3dPaulHarvey/Hexapod/_CODE/_REF/hexapod-main/hexapod-main/README.md

#  Hexapod

A 3D Printed Hexapod Robot

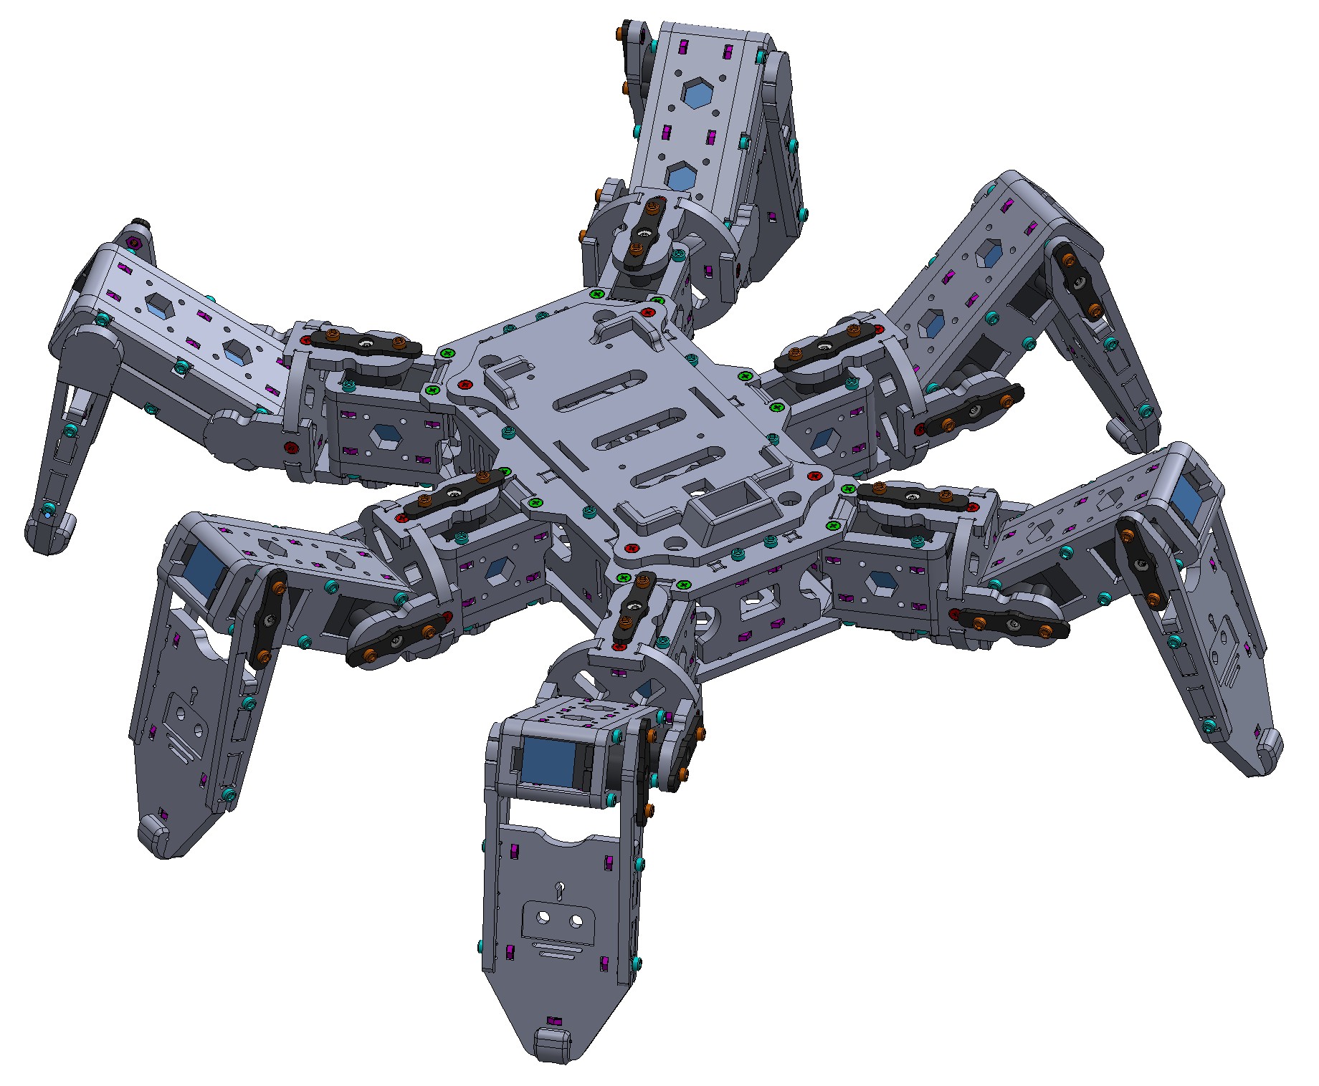
[picture p1: _CODE/_REF/hexapod-main/hexapod-main/images/hexapod_model.jpg]
hexapod_model


booting_up

## Introduction

This agile, 3D-printed hexapod robot, built with ESP32 and Arduino, offers a range of advanced features, including:

- A robust, durable structure
- WiFi-enabled remote control
- Smooth, agile movement
- Over-the-air (OTA) firmware updates for easy maintenance

### Watch on Youtube

youtube_booting_up (https://www.youtube.com/watch?v=QFQOPC1Mbdo)

youtube_remote_control (https://www.youtube.com/watch?v=YvXEto3tymQ)

## Electronics

| Name | Thumbnail | Required | Note |
| --- | --- | --- | --- |
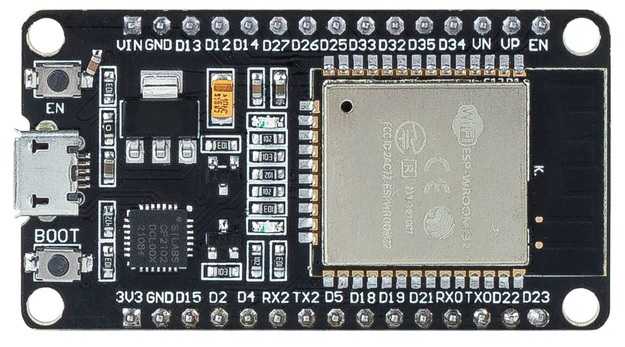
[picture p2: _CODE/_REF/hexapod-main/hexapod-main/images/esp32.jpg]
esp32
| ESP32 Dev Module |  | 1 | |
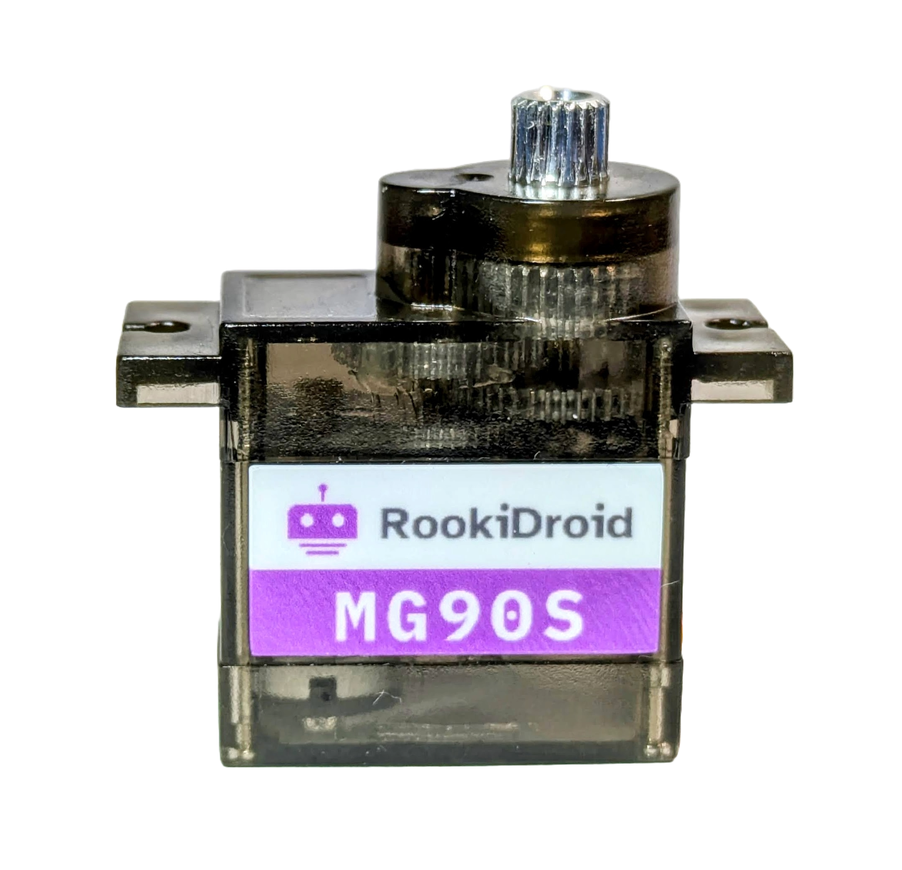
[picture p3: _CODE/_REF/hexapod-main/hexapod-main/images/mg90s.png]
mg90s
| MG92B or MG90S (metal gear)|  | 18 | Can be mixed |
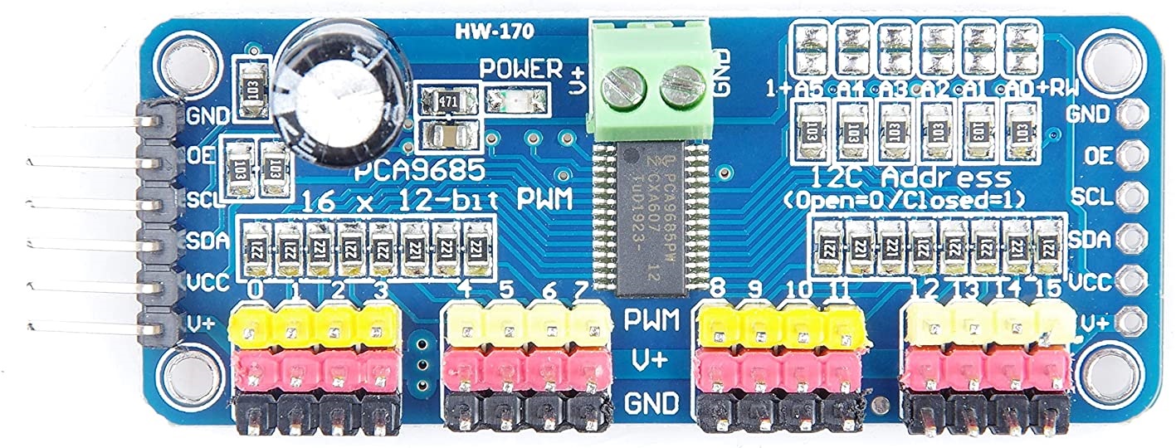
[picture p4: _CODE/_REF/hexapod-main/hexapod-main/images/PCA9685.jpg]
PCA9685
| PCA9685 servo driver |  | 2 | Need to be configured as different I2C addresss |
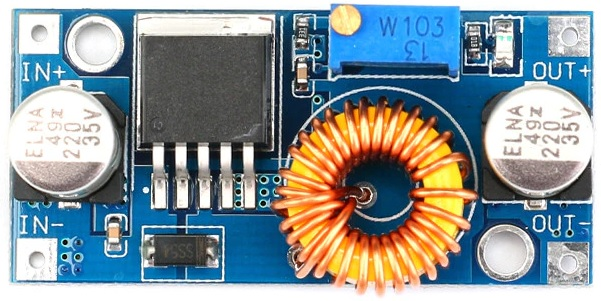
[picture p5: _CODE/_REF/hexapod-main/hexapod-main/images/XL4005.jpg]
XL4005
| XL4005 DC-DC step down |  | 2 | 6V output |
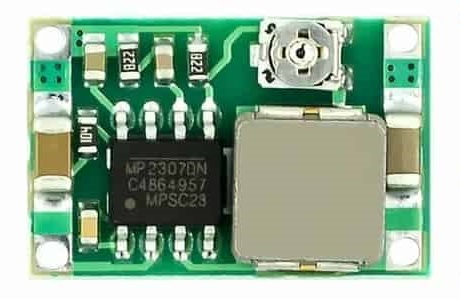
[picture p6: _CODE/_REF/hexapod-main/hexapod-main/images/mini360.jpg]
mini360
| Mini 360 DC-DC step down |  | 1 | 5V output |
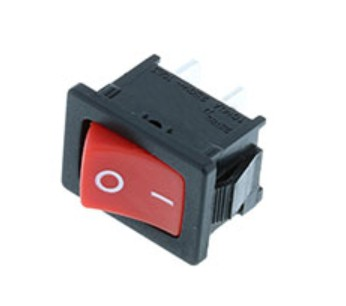
[picture p7: _CODE/_REF/hexapod-main/hexapod-main/images/switch.jpg]
switch
| Switch |  | 1 | |
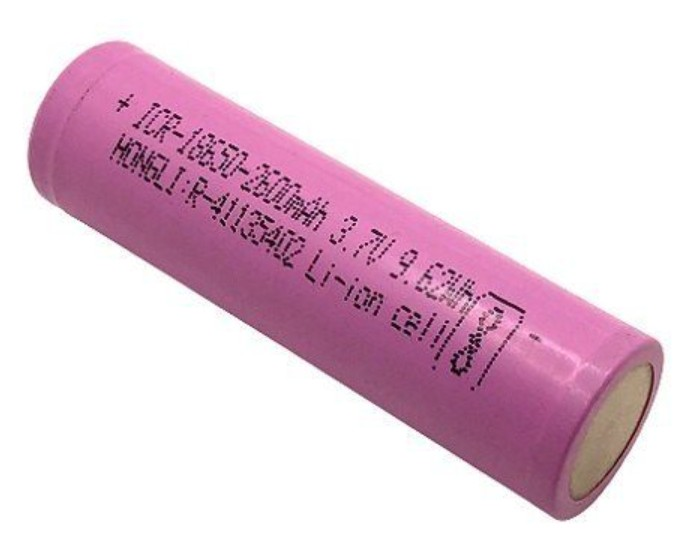
[picture p8: _CODE/_REF/hexapod-main/hexapod-main/images/battery.jpg]
battery
| 18650 battery |  | 2 | |
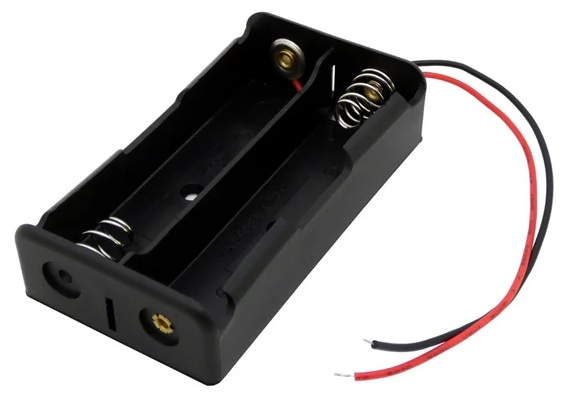
[picture p9: _CODE/_REF/hexapod-main/hexapod-main/images/battery_holder.jpg]
batter_holder
| 18650 battery holder |   | 1 | |

### Connection Diagram

diagram

## Assembly

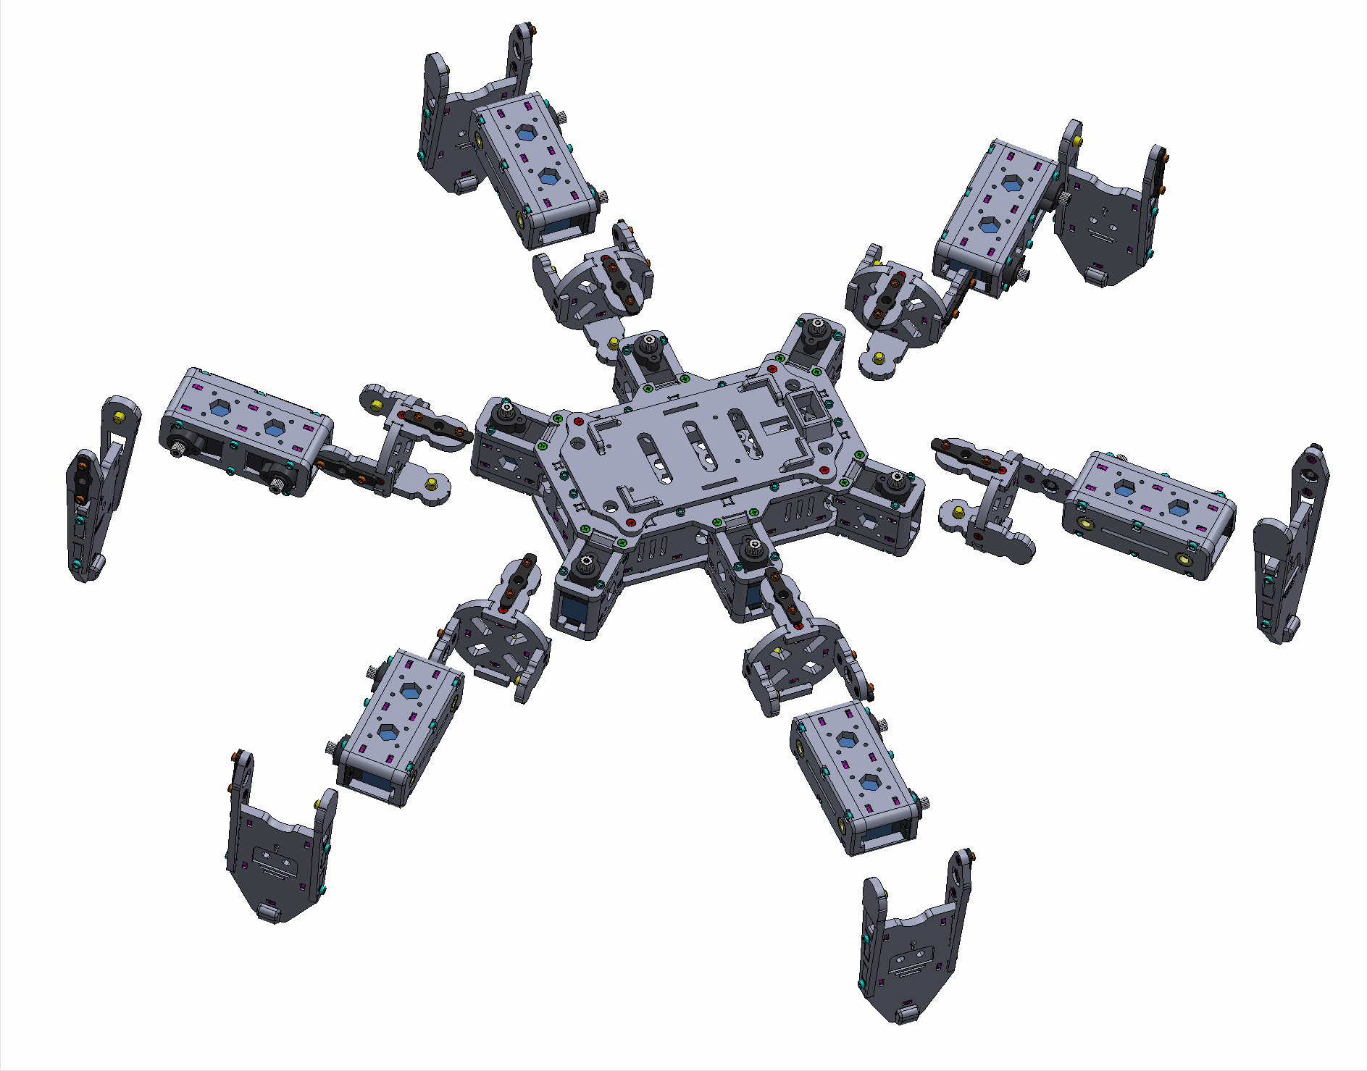
[picture p10: _CODE/_REF/hexapod-main/hexapod-main/images/assembly_whole.gif]
whole_assembly


### 3D-Printed Parts

#### Body x 1

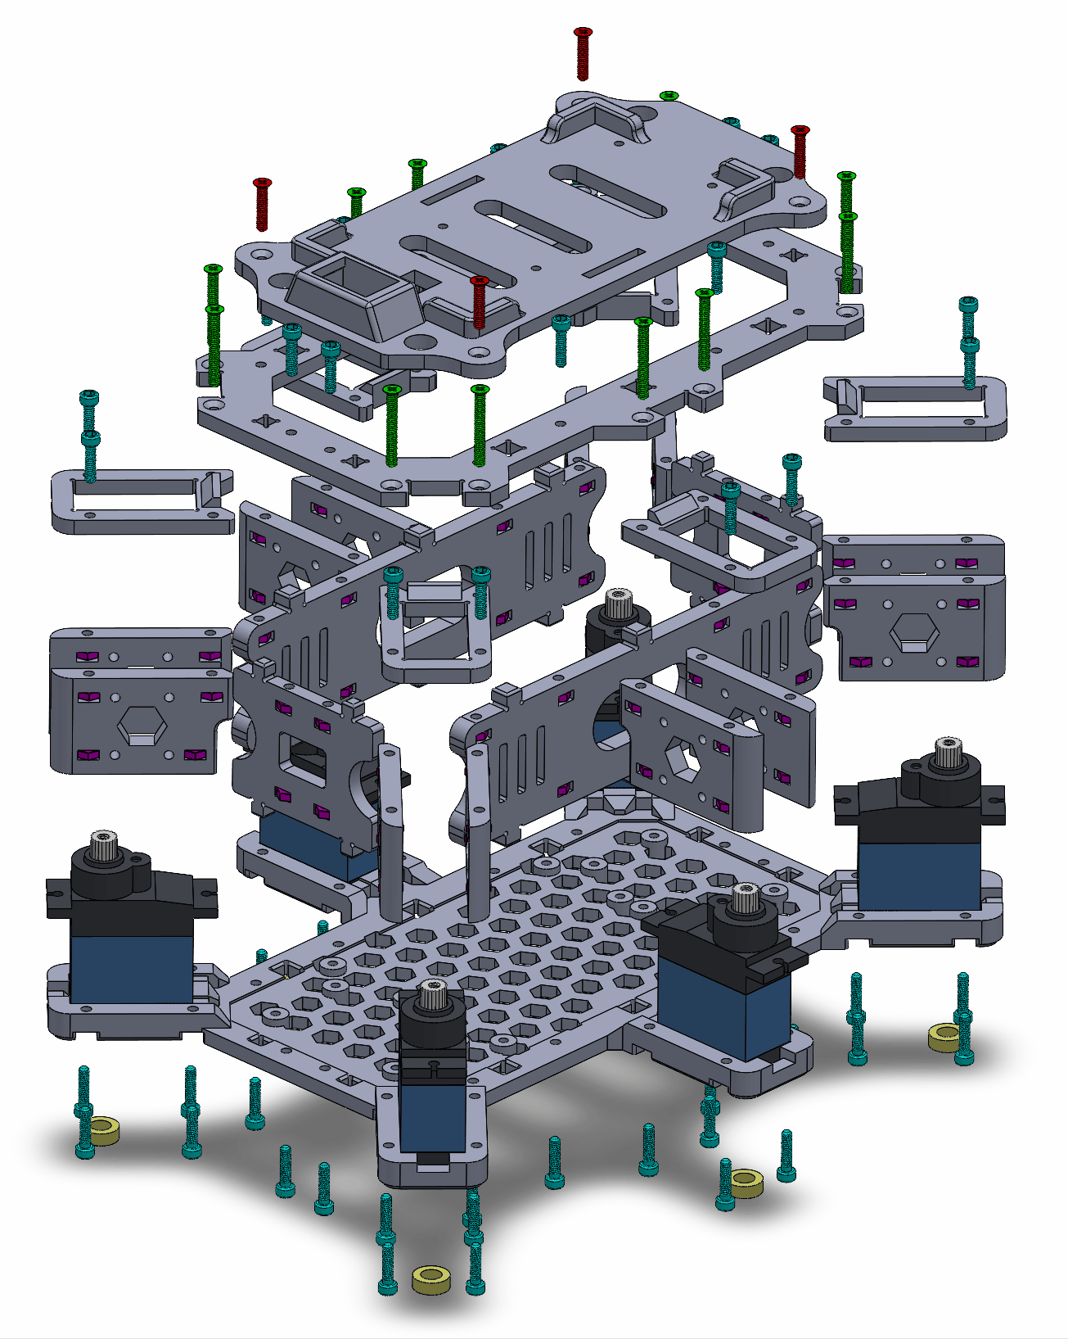
[picture p11: _CODE/_REF/hexapod-main/hexapod-main/images/assembly_body.gif]
body_assembly


| Filename | Thumbnail | Required |
| --- | --- | --- |
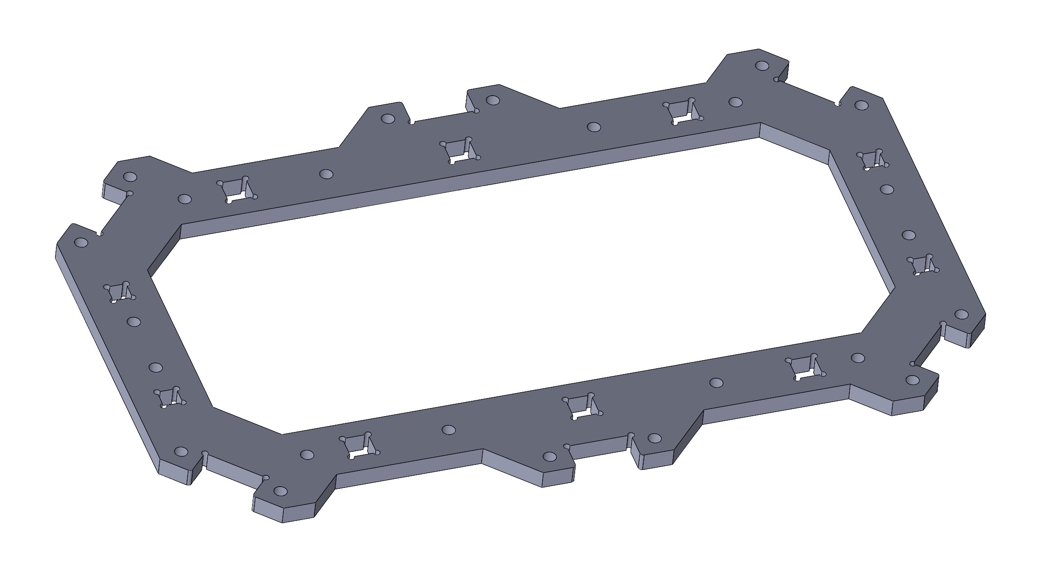
[picture p12: _CODE/_REF/hexapod-main/hexapod-main/images/body_top.jpg]
body_top
| body_top |  | 1 |
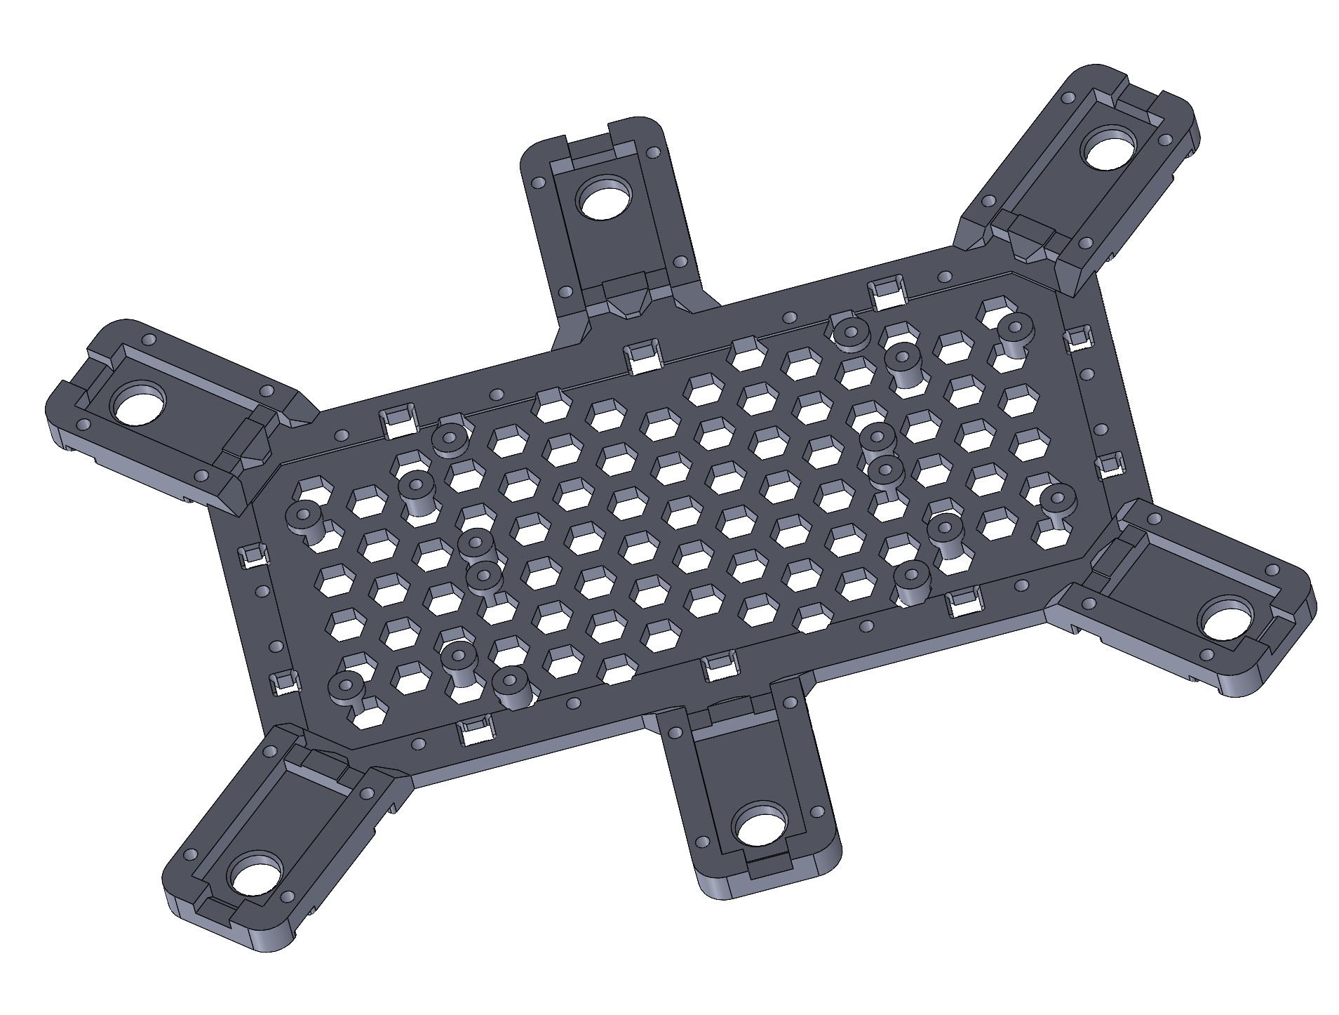
[picture p13: _CODE/_REF/hexapod-main/hexapod-main/images/body_base.jpg]
body_base
| body_base |  | 1 |
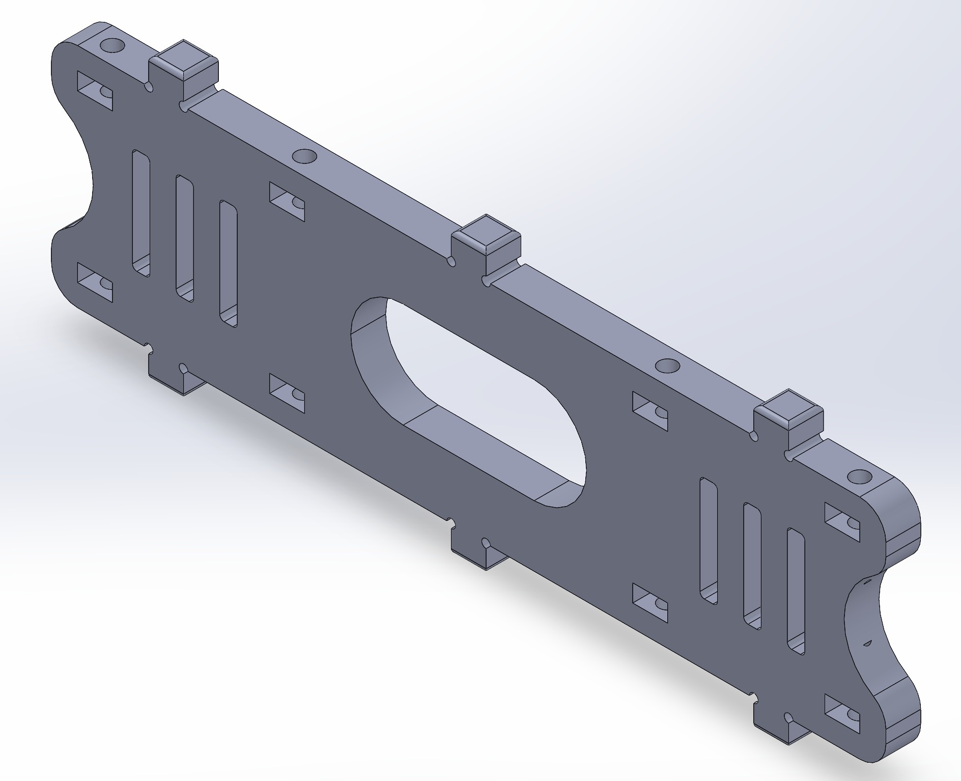
[picture p14: _CODE/_REF/hexapod-main/hexapod-main/images/body_side.jpg]
body_side
| body_side |  | 2 |
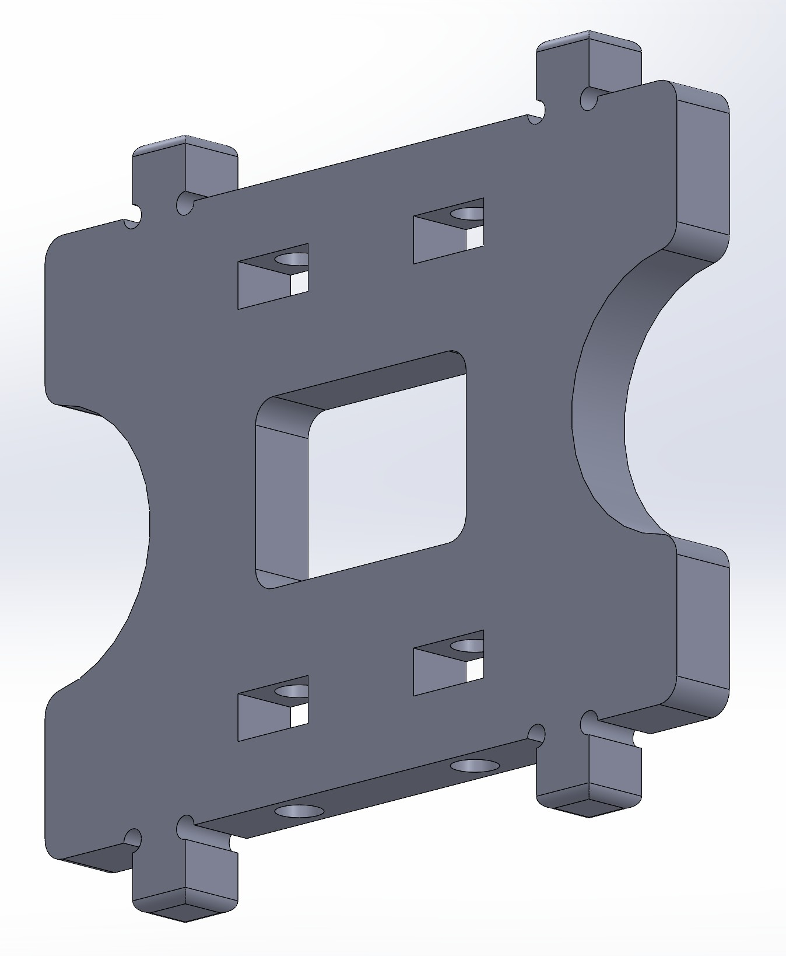
[picture p15: _CODE/_REF/hexapod-main/hexapod-main/images/body_front_back.jpg]
body_front_back
| body_front_back| | 2 |
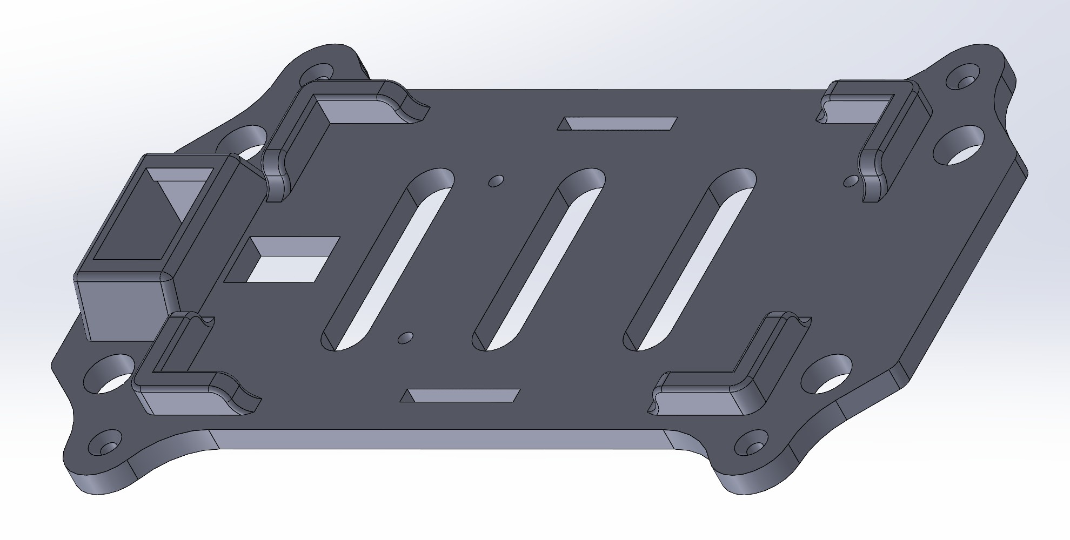
[picture p16: _CODE/_REF/hexapod-main/hexapod-main/images/body_battery.jpg]
body_battery
| body_battery |  | 1 |
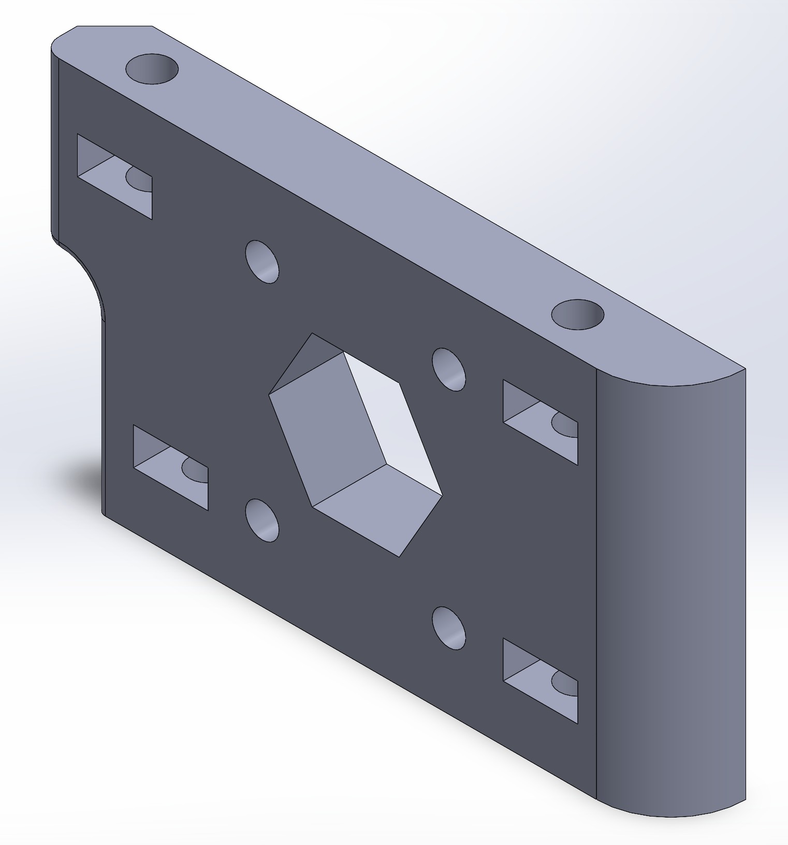
[picture p17: _CODE/_REF/hexapod-main/hexapod-main/images/body_servo_side1.jpg]
body_servo_side1
| body_servo_side1 |  | 6 |
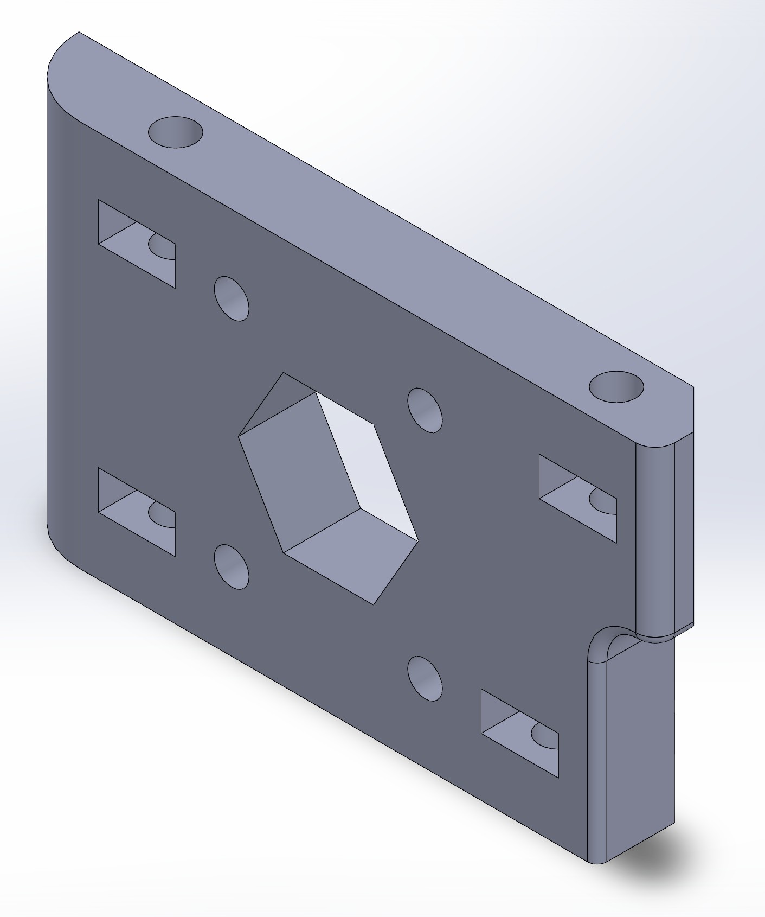
[picture p18: _CODE/_REF/hexapod-main/hexapod-main/images/body_servo_side2.jpg]
body_servo_side2
| body_servo_side2 |  | 6 |
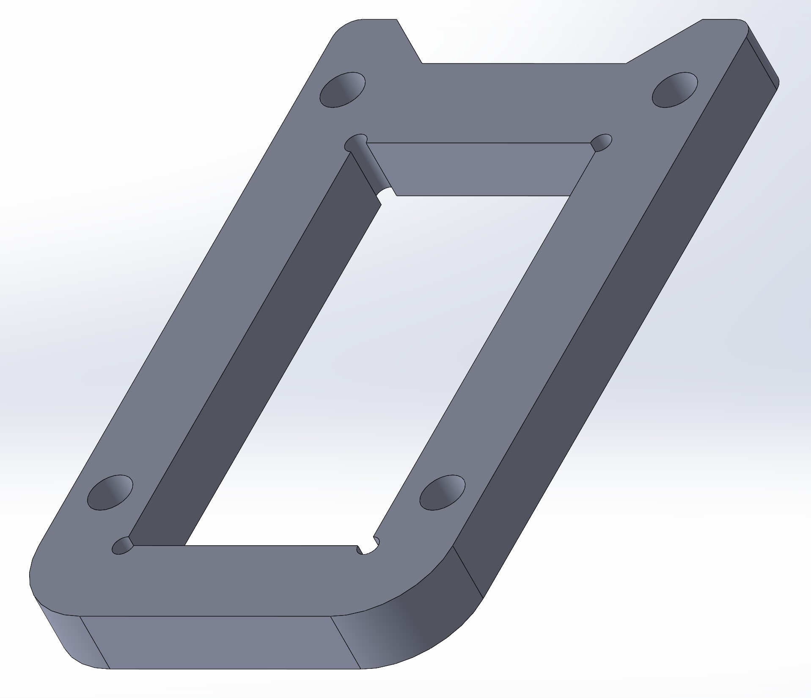
[picture p19: _CODE/_REF/hexapod-main/hexapod-main/images/body_servo_top.jpg]
body_servo_top
| body_servo_top |  | 6 |

#### Joint x 3 + Mirrored Joint x 3

*Check the images of the fully assembled robot for the orientations of the joints and the mirrored joints*

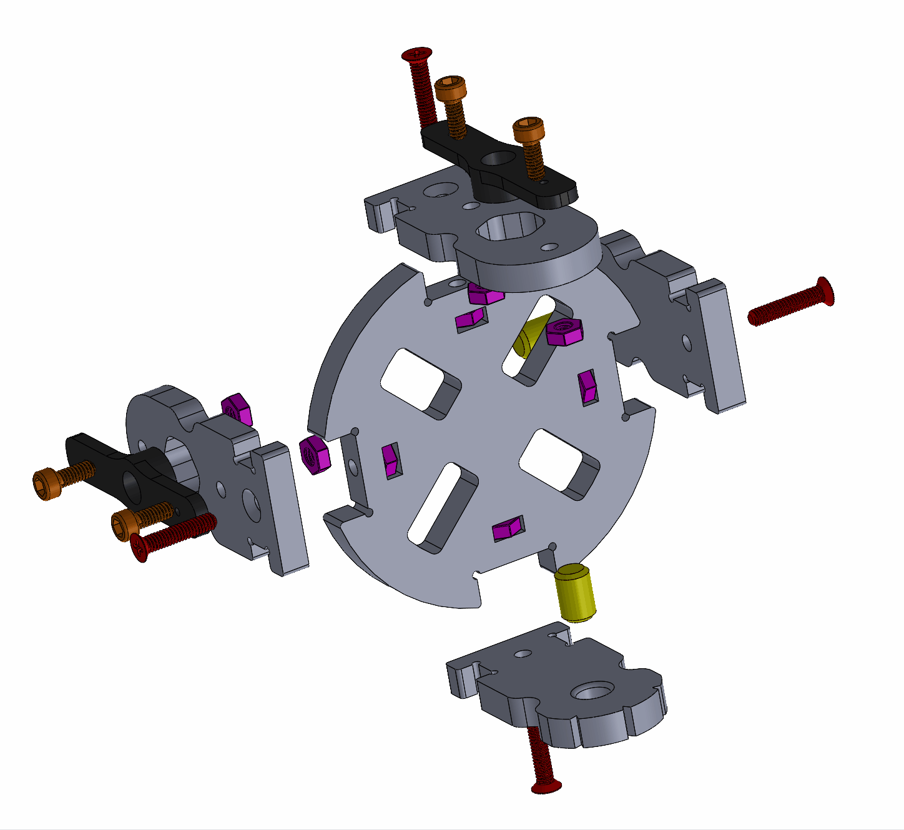
[picture p20: _CODE/_REF/hexapod-main/hexapod-main/images/assembly_joint.gif]
joint_assembly


| Filename | Thumbnail | Required | Note |
| --- | --- | --- | --- |
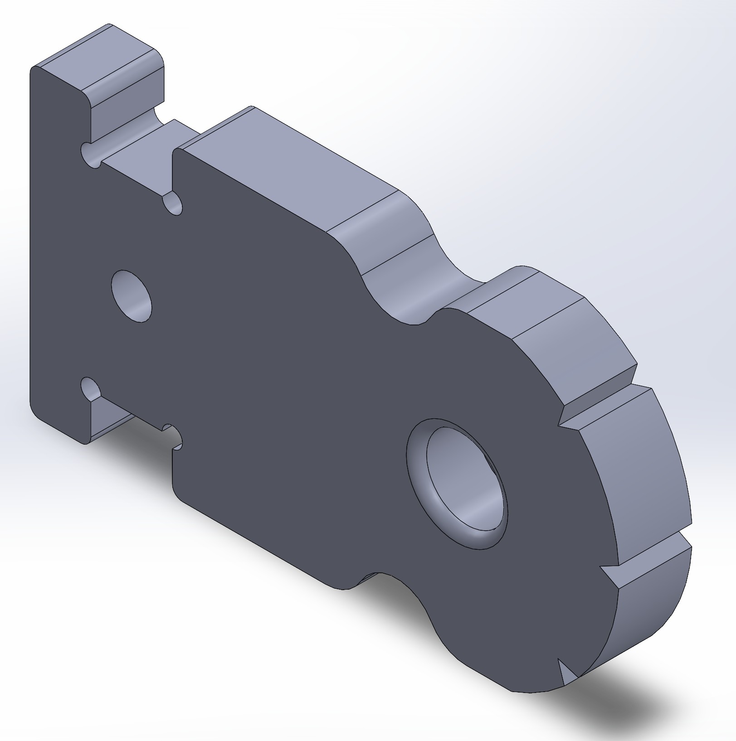
[picture p21: _CODE/_REF/hexapod-main/hexapod-main/images/joint_bottom.jpg]
joint_bottom
| joint_bottom |  | 12 | |
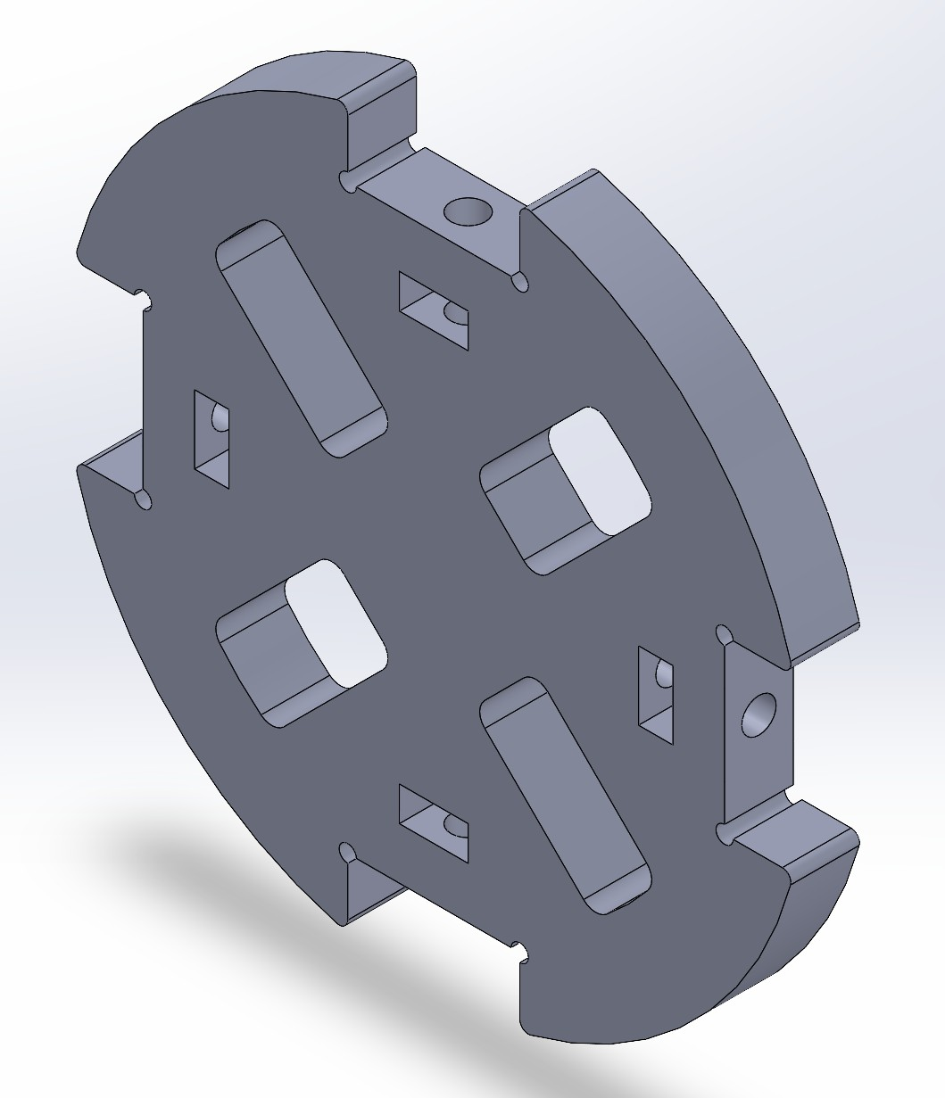
[picture p22: _CODE/_REF/hexapod-main/hexapod-main/images/joint_cross.jpg]
joint_cross
| joint_cross |  | 6 | |
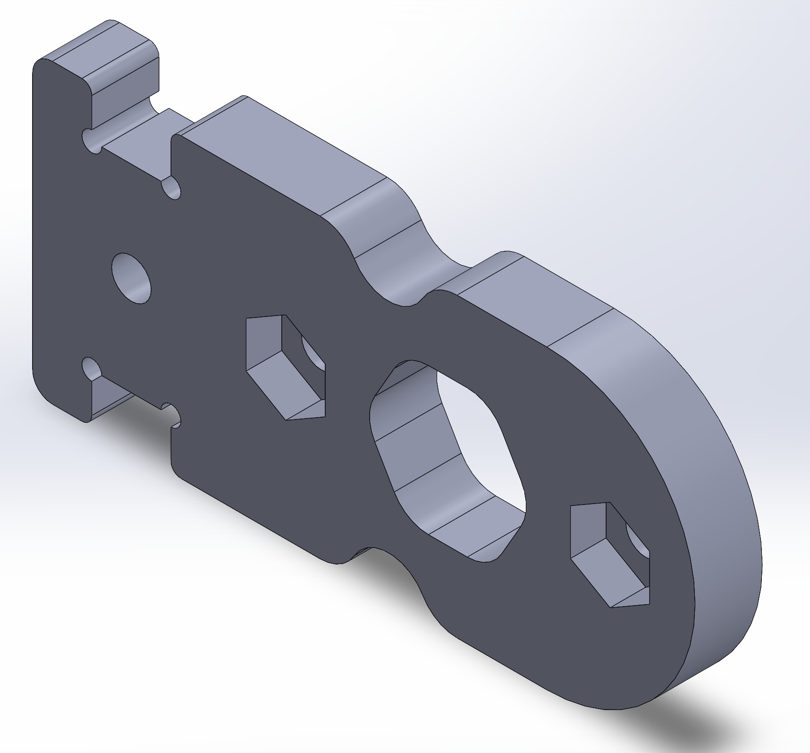
[picture p23: _CODE/_REF/hexapod-main/hexapod-main/images/joint_top_mg90s.jpg]
joint_top_mg90s
| joint_top_mg90s |  | 12 | For MG90S |
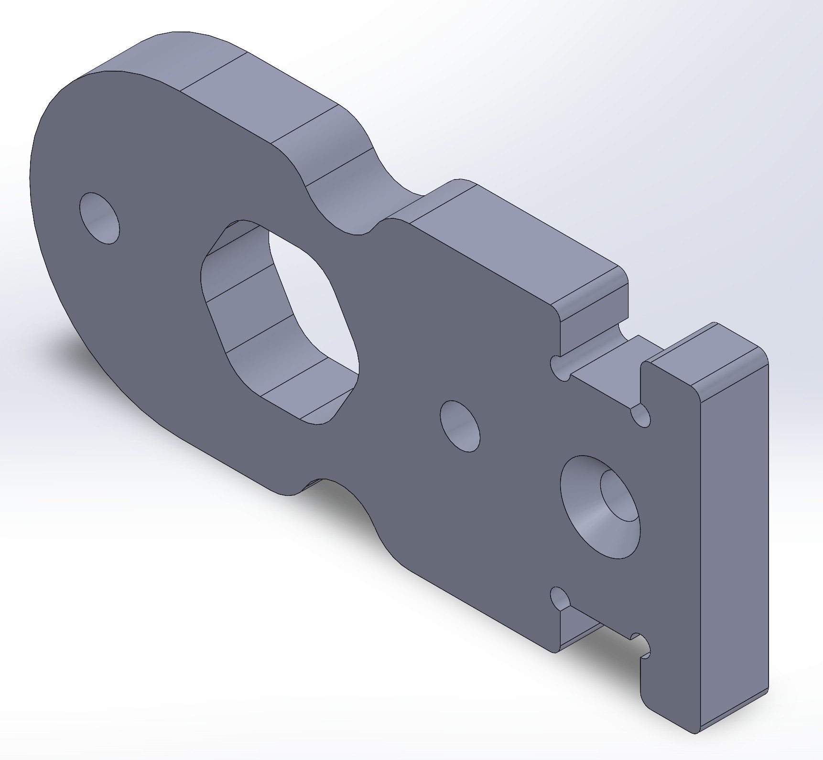
[picture p24: _CODE/_REF/hexapod-main/hexapod-main/images/joint_top_mg92b.jpg]
joint_top_mg92b
| joint_top_mg92b |  | 12 | For MG92B |

#### Leg x 6

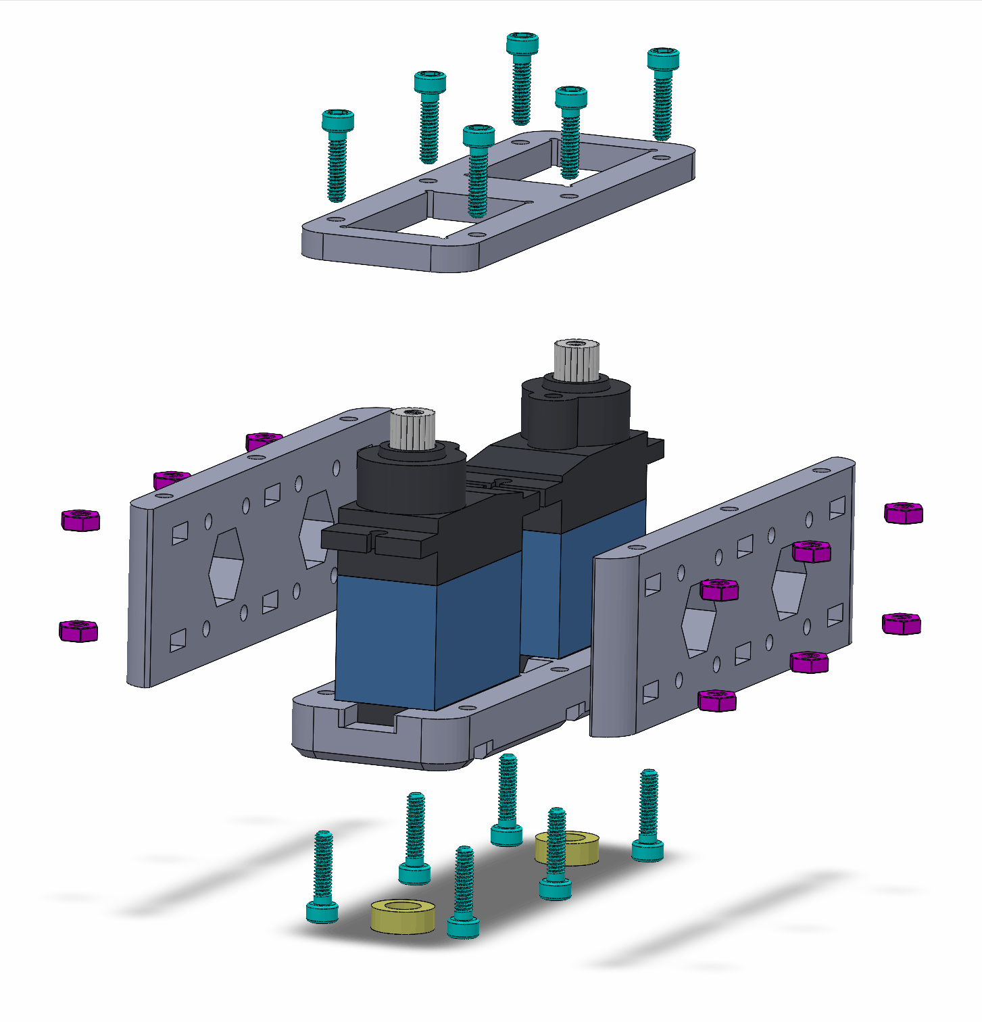
[picture p25: _CODE/_REF/hexapod-main/hexapod-main/images/assembly_leg.gif]
leg_assembly


| Filename | Thumbnail | Required |
| --- | --- | --- |
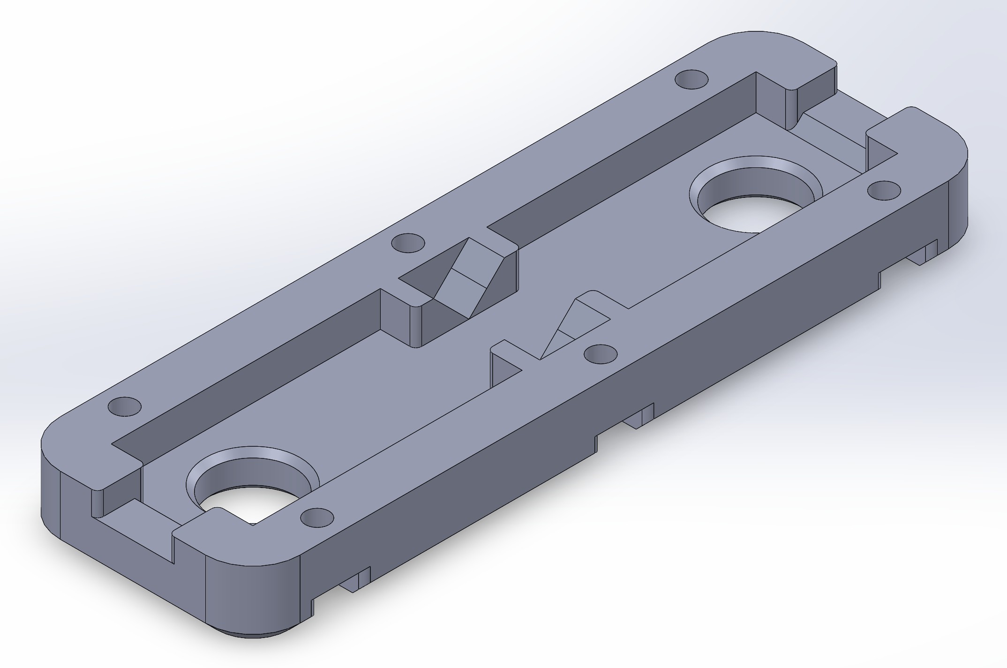
[picture p26: _CODE/_REF/hexapod-main/hexapod-main/images/leg_bottom.jpg]
leg_bottom
| leg_bottom |  | 6 |
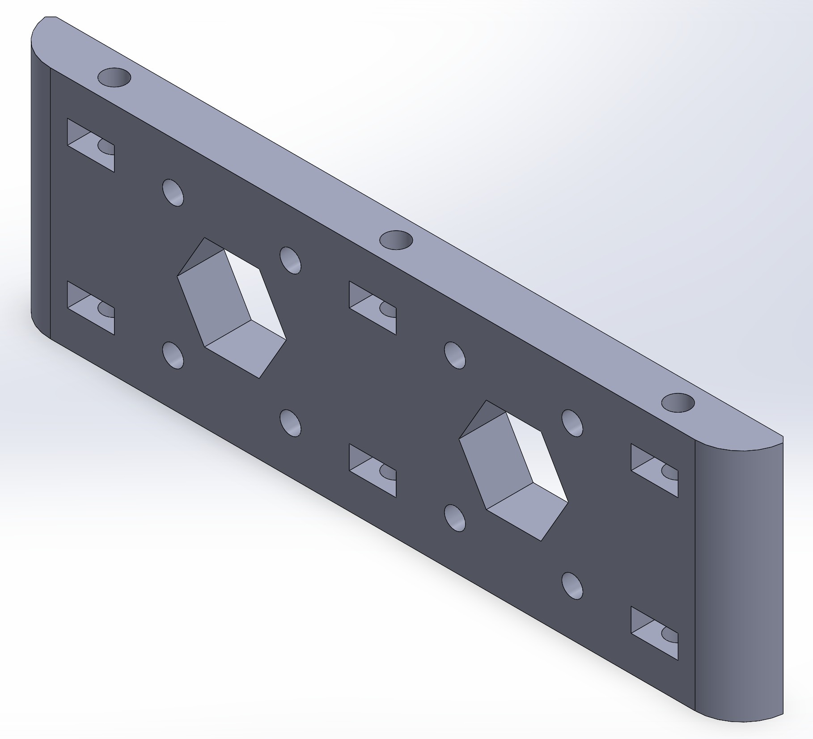
[picture p27: _CODE/_REF/hexapod-main/hexapod-main/images/leg_side.jpg]
leg_side
| leg_side |  | 12 |
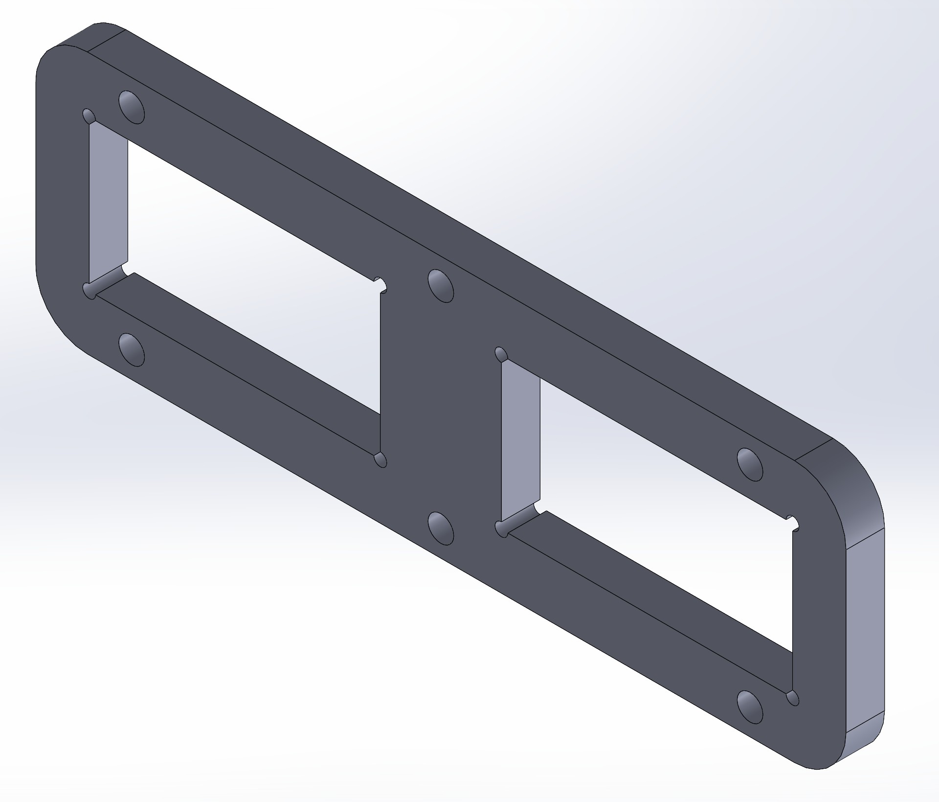
[picture p28: _CODE/_REF/hexapod-main/hexapod-main/images/leg_top.jpg]
leg_top
| leg_top |  | 6 |

#### Foot x 3 + Mirrored Foot x 3

*Check the images of the fully assembled robot for the orientations of the feet and the mirrored feet*

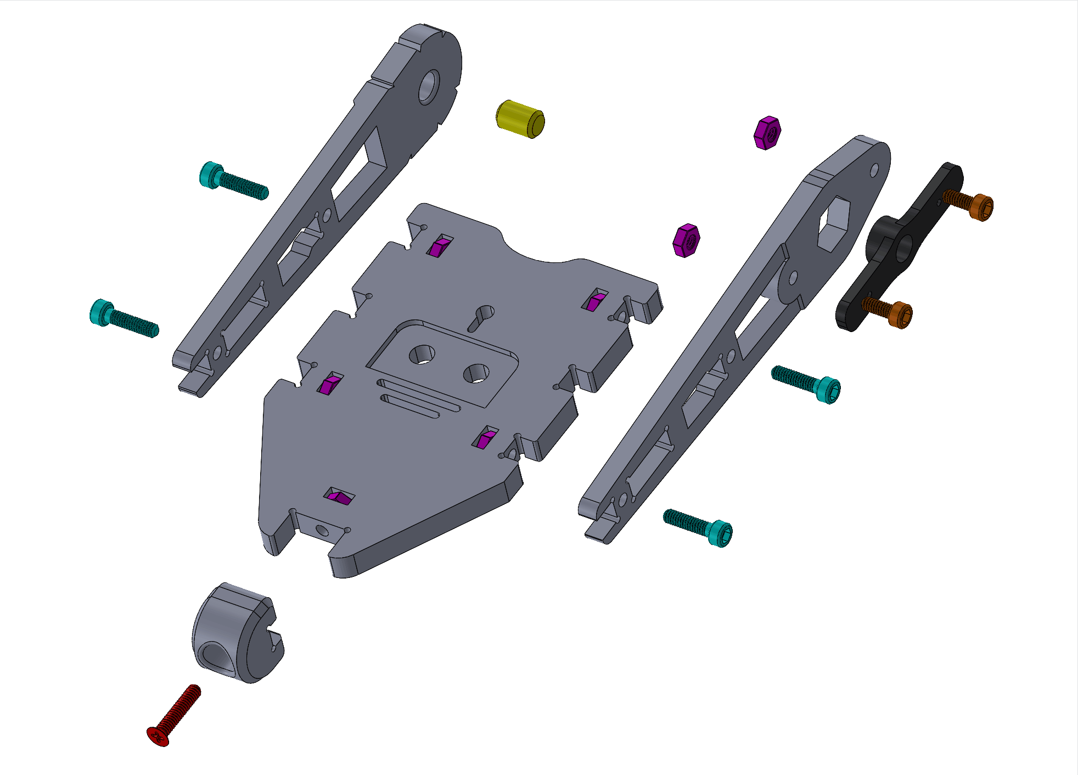
[picture p29: _CODE/_REF/hexapod-main/hexapod-main/images/assembly_foot.gif]
foot_assembly


| Filename | Thumbnail | Required | Note |
| --- | --- | --- | --- |
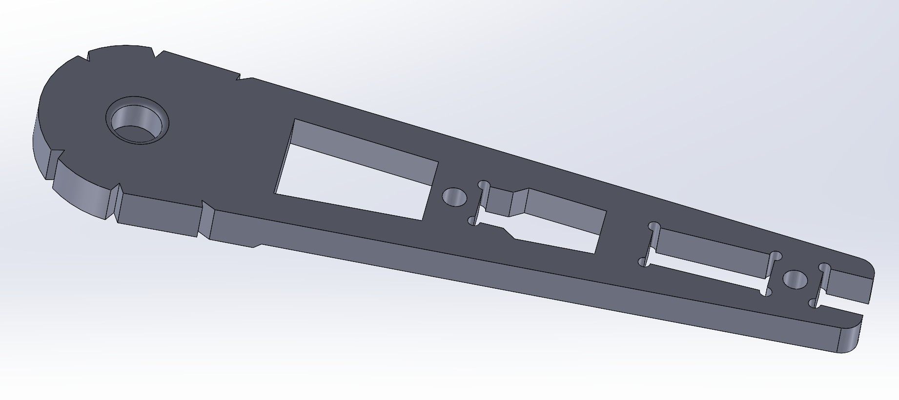
[picture p30: _CODE/_REF/hexapod-main/hexapod-main/images/foot_bottom.jpg]
foot_bottom
| foot_bottom |  | 6 | |
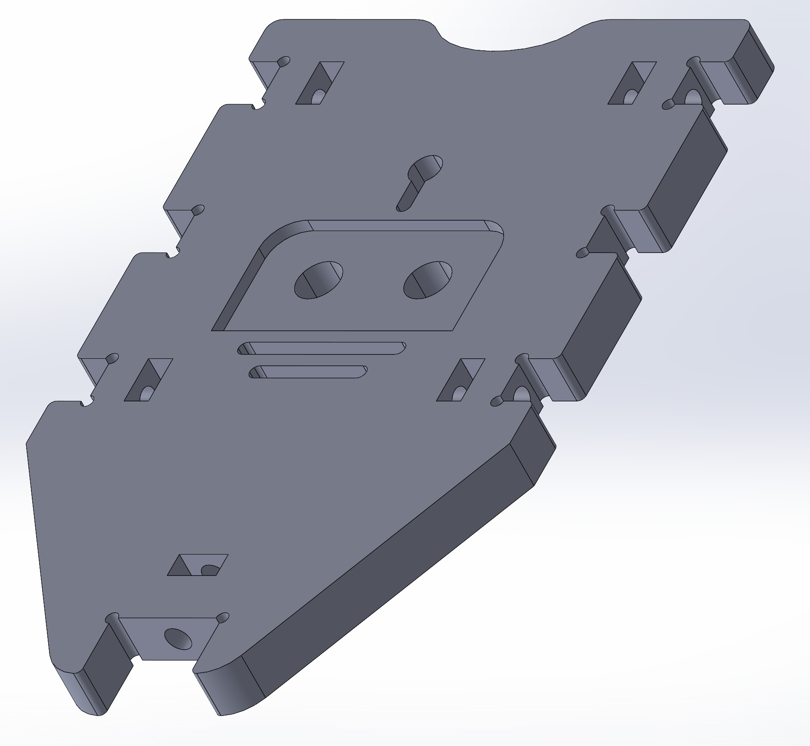
[picture p31: _CODE/_REF/hexapod-main/hexapod-main/images/foot_ground.jpg]
foot_ground
| foot_ground |  | 6 | |
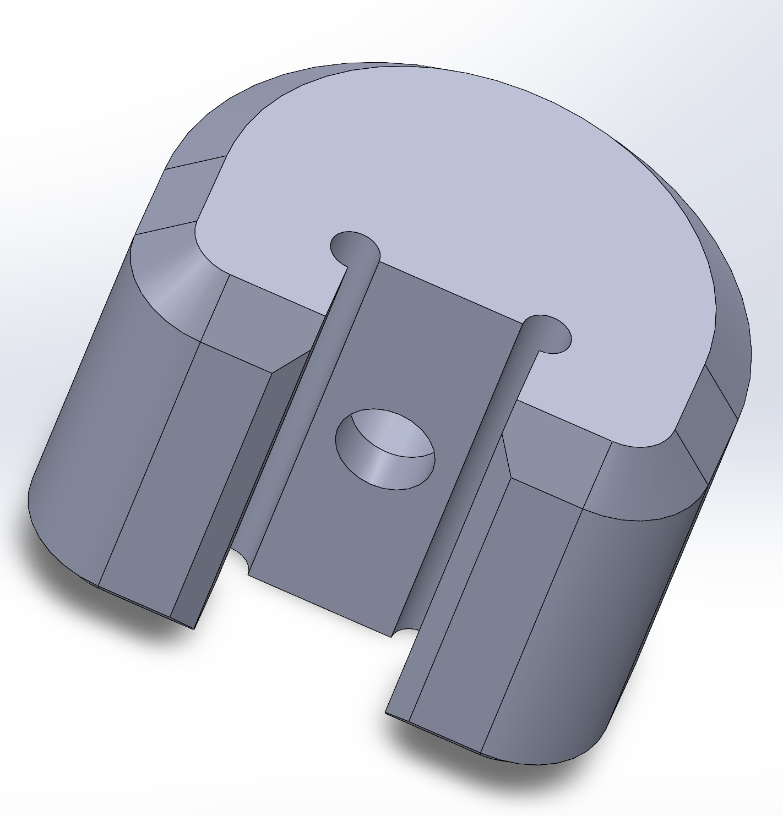
[picture p32: _CODE/_REF/hexapod-main/hexapod-main/images/foot_tip.jpg]
foot_tip
| foot_tip |  | 6 | |
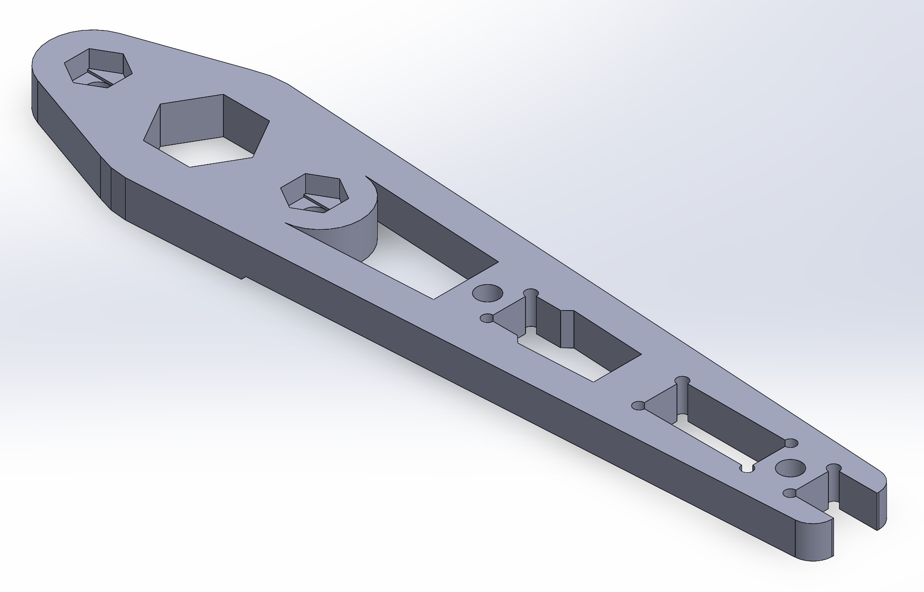
[picture p33: _CODE/_REF/hexapod-main/hexapod-main/images/foot_top_mg90s.jpg]
foot_top_mg90s
| foot_top_mg90s  |  | 6 | For MG90S |
| foot_top_mg92b  | foot_top_mg92b | 6 | For MG92B |

#### Accessory

| Filename | Thumbnail | Note |
| --- | --- | --- |
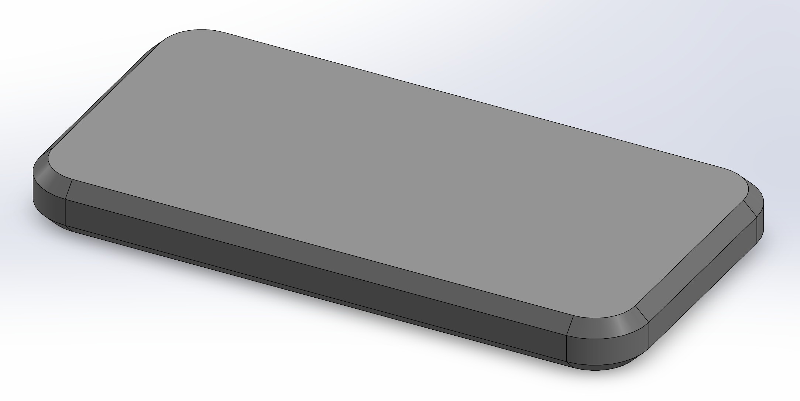
[picture p34: _CODE/_REF/hexapod-main/hexapod-main/images/accessory_spacer_mg90s.jpg]
accessory_spacer_mg90s
| accessory_spacer_mg90s |  | Spacer for MG90S |
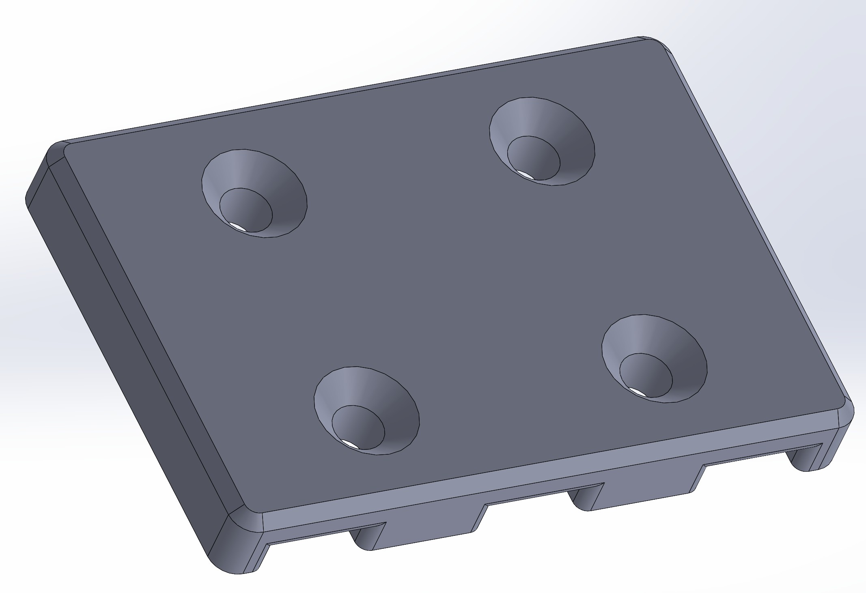
[picture p35: _CODE/_REF/hexapod-main/hexapod-main/images/accessory_cable_holder.jpg]
accessory_cable_holder
| accessory_cable_holder |  | |

### Others

| Name | Spec | Required |
| --- | --- | --- |
| Screw | M2 6mm  | 36 |
| Screw | M2 10mm | 198 |
| Nuts | M2 | 234 |
| Pin (304) | M4 6mm  | 18 |
| Bearing | MR74-2RS (4mm ID, 7mm OD, 2.5mm Bore) | 18 |

## Software

hexapod_model_label

### ESP32-Arduino

Source code is under `./hexapod_arduino`.

- `hexapod_arduino.ino`: Main Arduino sketch
- `config.h`: Configuration header. Change the configurations based on your servo connections
- `motion.h`: Automatically generated motion look-up-table using `path_tool'

### Android

*Working in progress*

### PC

*Working in progress*

## Calibration

Check the following image for the initial positions of all the leg joints while all the servos are at 90 deg.

Adjust the following two lines in in `config.h` to correct the installation offsets.

```c
static int left_offset_ticks[3][3] = {{-5, 10, 0}, {-15, 5, -20}, {20, -10, 10}};
static int right_offset_ticks[3][3] = {{20, -10, 0}, {-15, 0, -5}, {-10, 0, -20}};
```

calibration
