3dPaulHarvey/Hexapod/_NOTES.txt

put aster servos in the hips
servo horn screws facing outward, screw little horns on them

make him cyborg
MECH AZMODAN
using vitaly parts
