3dPaulHarvey/Hexapod/_ART/_REF/azmodan-color-hots/textures/storm_hero_azmodan_emis.png

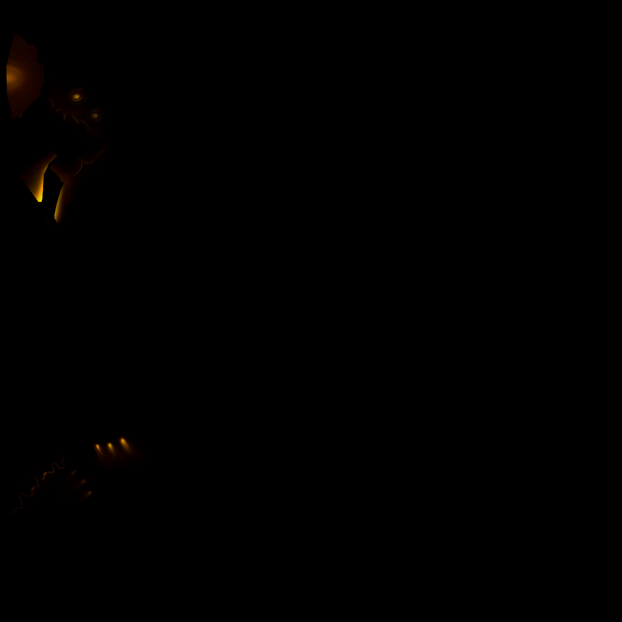
_ART/_REF/azmodan-color-hots/textures/storm_hero_azmodan_emis.png
