3dPaulHarvey/Hexapod/_CAD/ASSEM-SUB- SINGLE LEG.SLDASM

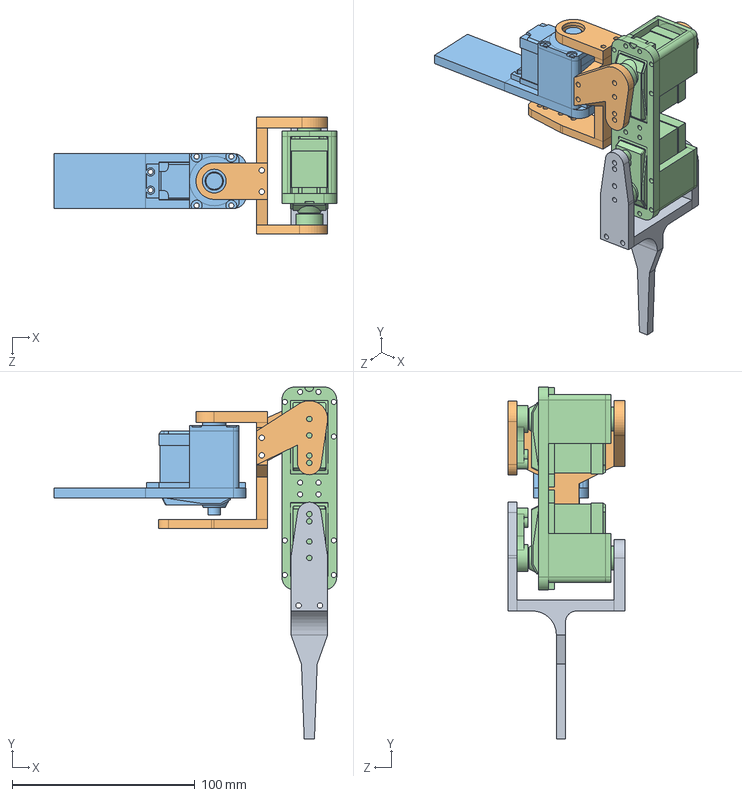
[picture p37: CAD file, 2026-02-27]
_CAD/ASSEM-SUB- SINGLE LEG.SLDASM
154.5 x 192.5 x 63.9 mm
KNEE LINK- AZHEX
HIP BASE- AZHEX
HIP KNEE CONNECTOR- AZHEX
END EFFECTOR- AZHEX
