3dPaulHarvey/Hexapod/_CODE/_REF/hexapod-main/hexapod-main/mechanism/body_servo_side2.STL

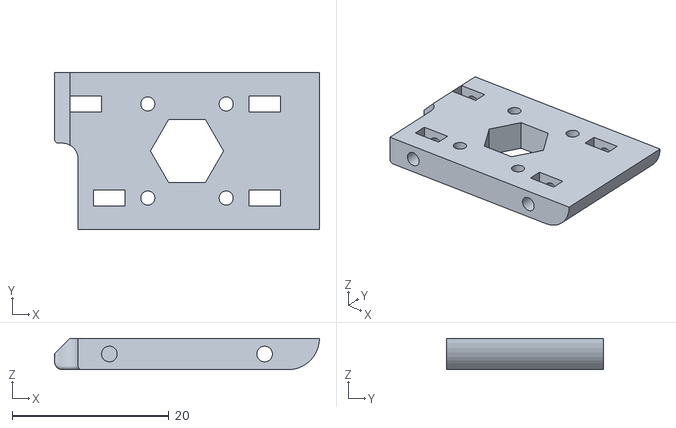
[picture p38: CAD file, 2026-02-14]
_CODE/_REF/hexapod-main/hexapod-main/mechanism/body_servo_side2.STL
33.8 x 20.0 x 4.00
