3dPaulHarvey/Hexapod/_CAD/KNEE LINK- AZHEX.SLDPRT

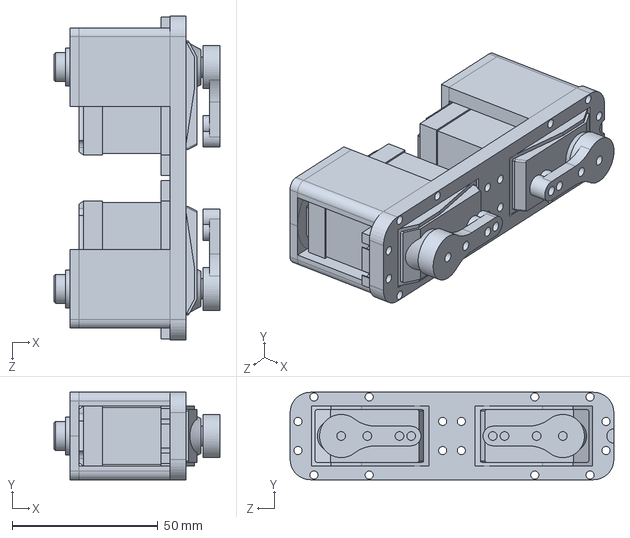
[picture p39: CAD file, 2026-02-27]
_CAD/KNEE LINK- AZHEX.SLDPRT
56.9 x 30.0 x 111.0 mm
