3dPaulHarvey/Hexapod/_CODE/_REF/hexapod-main/hexapod-main/mechanism/joint_top_mg90s.STL

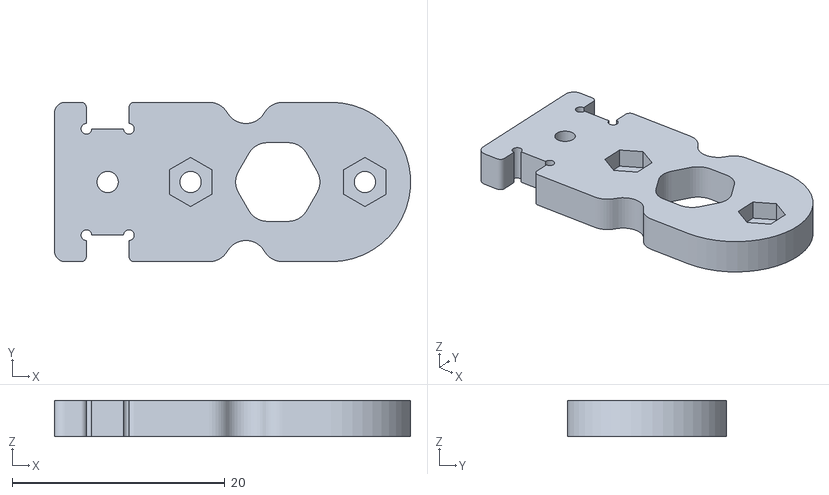
[picture p40: CAD file, 2026-02-14]
_CODE/_REF/hexapod-main/hexapod-main/mechanism/joint_top_mg90s.STL
33.5 x 15.0 x 3.40
