3dPaulHarvey/Hexapod/_CODE/_REF/hexapod-main/hexapod-main/mechanism/foot_ground.STL

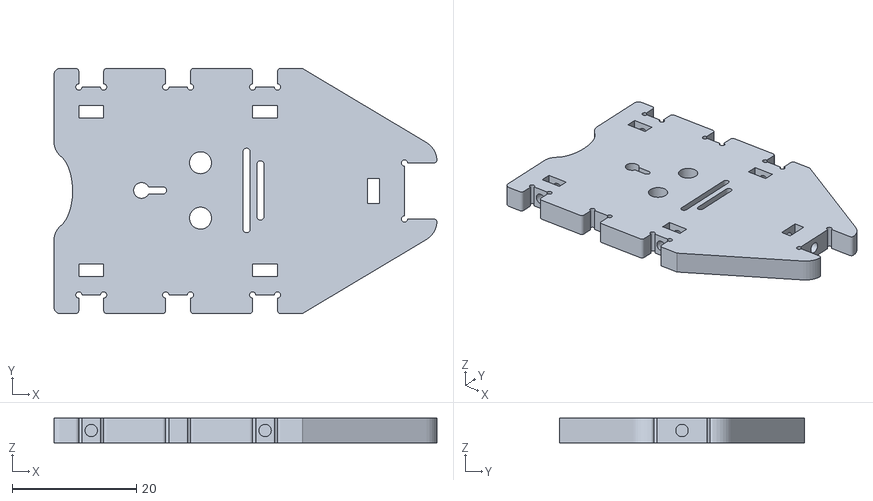
[picture p41: CAD file, 2026-02-14]
_CODE/_REF/hexapod-main/hexapod-main/mechanism/foot_ground.STL
61.7 x 39.5 x 4.00
