3dPaulHarvey/Hexapod/_CODE/_REF/hexapod-main/hexapod-main/mechanism/foot_top_mg92b.STL

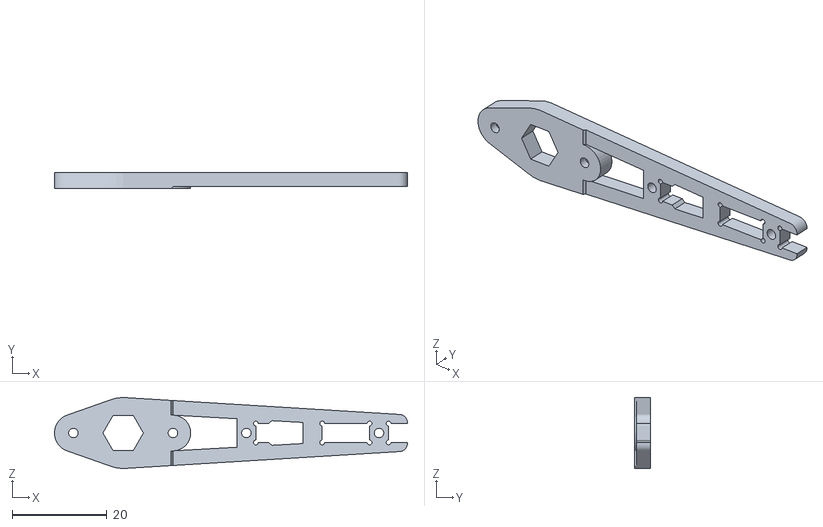
[picture p42: CAD file, 2026-02-14]
_CODE/_REF/hexapod-main/hexapod-main/mechanism/foot_top_mg92b.STL
74.5 x 3.40 x 15.0
