3dPaulHarvey/Hexapod/_CODE/_REF/hexapod-main/hexapod-main/mechanism/accessory_spacer_mg90s.STL

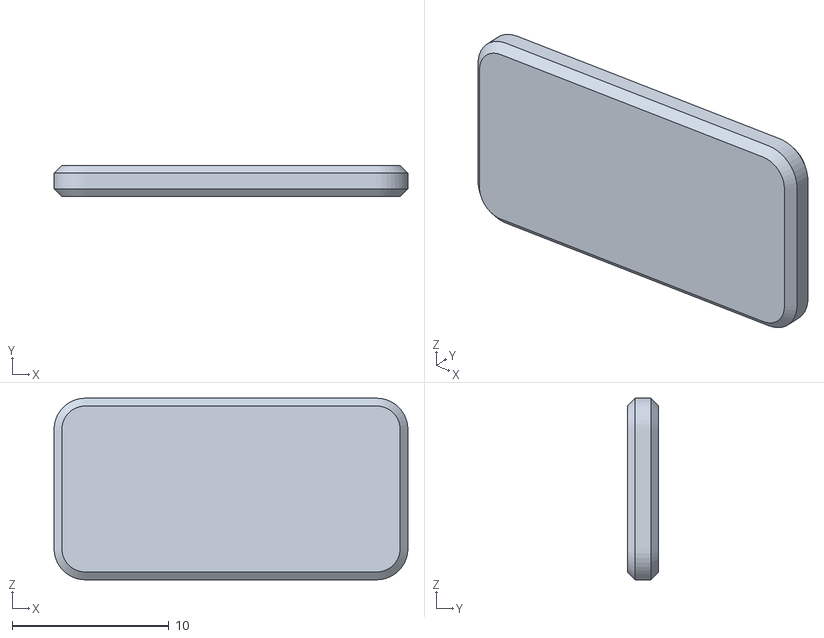
[picture p43: CAD file, 2026-02-14]
_CODE/_REF/hexapod-main/hexapod-main/mechanism/accessory_spacer_mg90s.STL
22.6 x 2.00 x 11.6
