3dPaulHarvey/Hexapod/_CAD/END EFFECTOR- AZHEX.SLDPRT

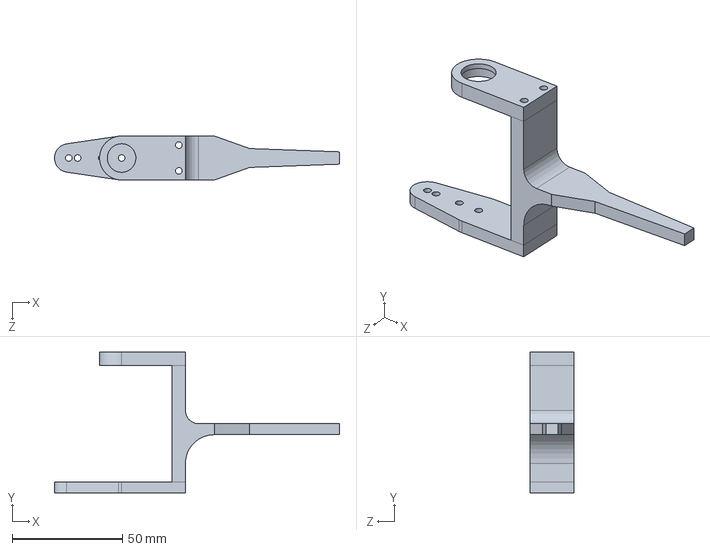
[picture p44: CAD file, 2026-02-27]
_CAD/END EFFECTOR- AZHEX.SLDPRT
129.5 x 63.9 x 20.0 mm
