3dPaulHarvey/Hexapod/_CODE/_REF/hexapod-main/hexapod-main/mechanism/accessory_small_spacer_mg90s.stl

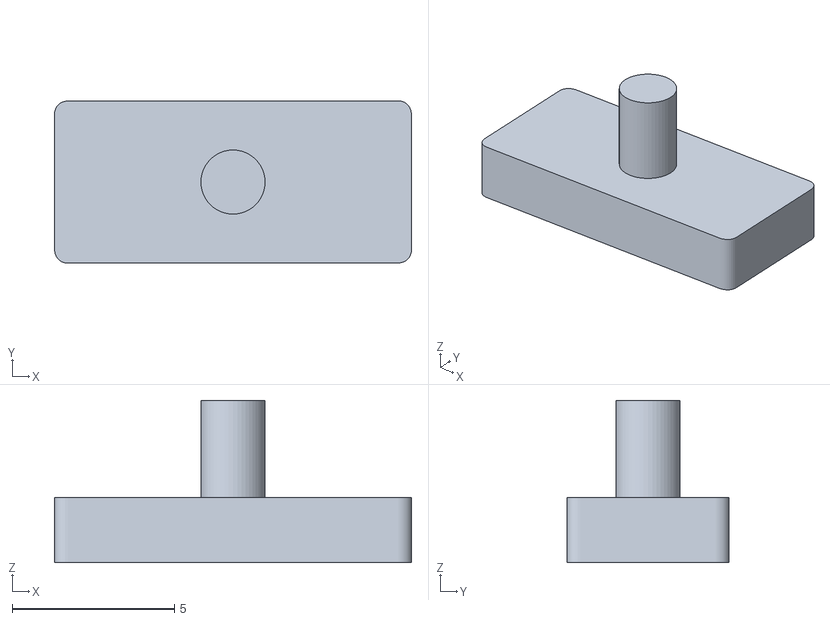
[picture p45: CAD file, 2026-02-14]
_CODE/_REF/hexapod-main/hexapod-main/mechanism/accessory_small_spacer_mg90s.stl
11.0 x 5.00 x 5.00
