3dPaulHarvey/Hexapod/_CODE/_REF/hexapod-main/hexapod-main/mechanism/joint_bottom.STL

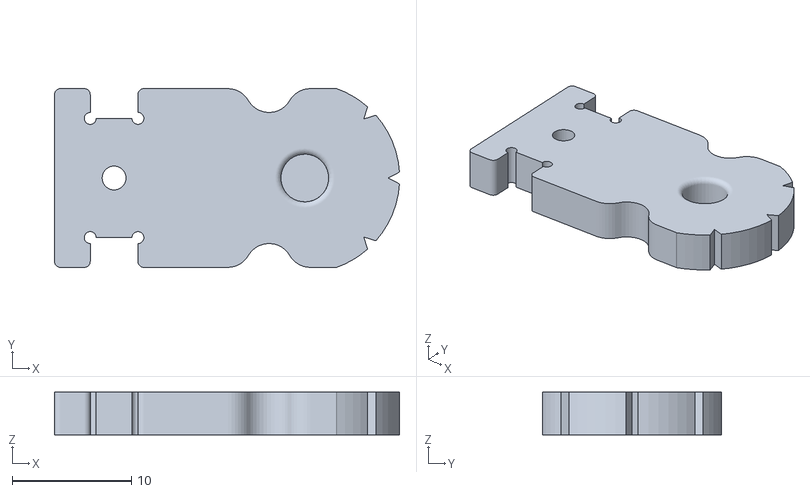
[picture p46: CAD file, 2026-02-14]
_CODE/_REF/hexapod-main/hexapod-main/mechanism/joint_bottom.STL
28.9 x 15.0 x 3.60
