3dPaulHarvey/Hexapod/_CAD/HIP KNEE CONNECTOR- AZHEX.SLDPRT

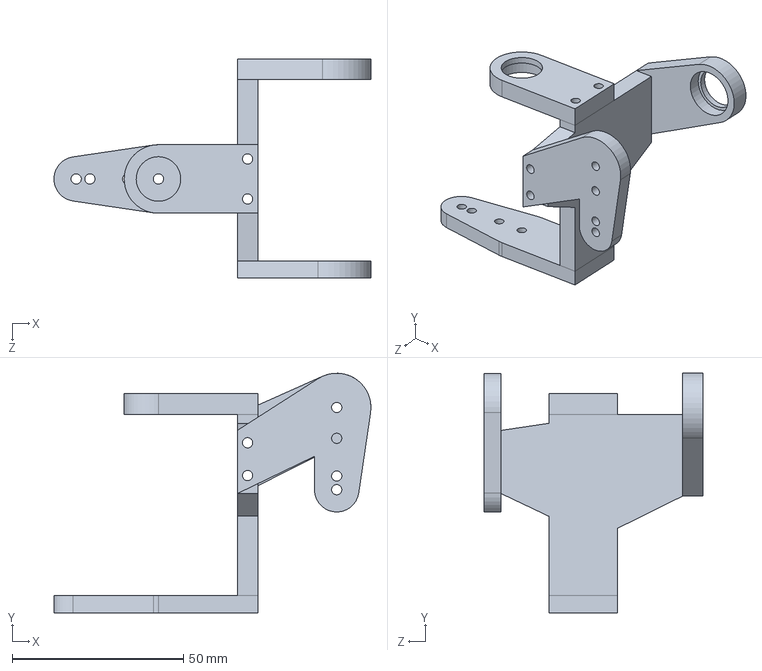
[picture p47: CAD file, 2026-02-27]
_CAD/HIP KNEE CONNECTOR- AZHEX.SLDPRT
92.5 x 69.9 x 63.9 mm
