3dPaulHarvey/Hexapod/_CODE/_REF/hexapod-main/hexapod-main/mechanism/body_top.STL

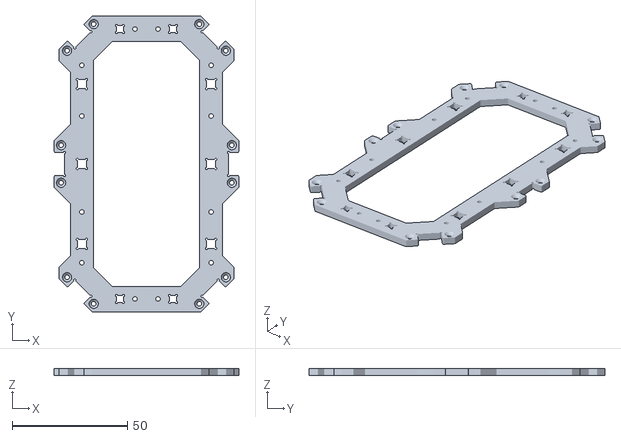
[picture p48: CAD file, 2026-02-14]
_CODE/_REF/hexapod-main/hexapod-main/mechanism/body_top.STL
80.0 x 128.3 x 3.00
