3dPaulHarvey/Hexapod/_CODE/_REF/hexapod-main/hexapod-main/mechanism/body_servo_top.STL

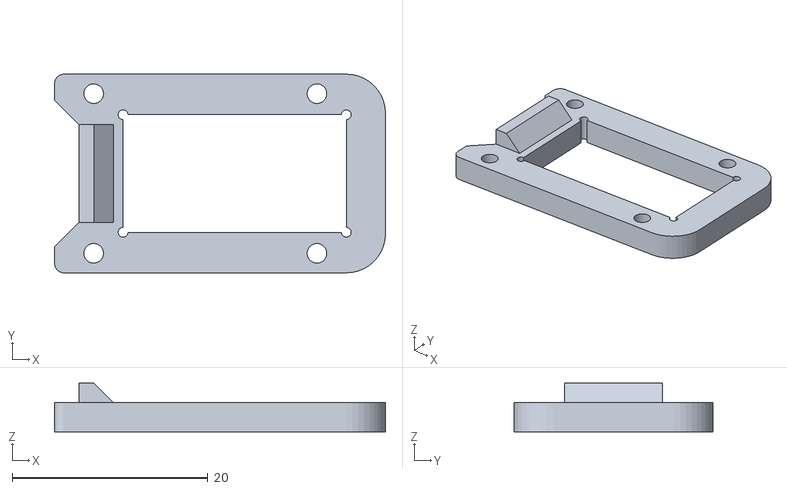
[picture p49: CAD file, 2026-02-14]
_CODE/_REF/hexapod-main/hexapod-main/mechanism/body_servo_top.STL
33.8 x 20.3 x 5.00
