3dPaulHarvey/Hexapod/_CODE/_REF/hexapod-main/hexapod-main/mechanism/joint_cross.STL

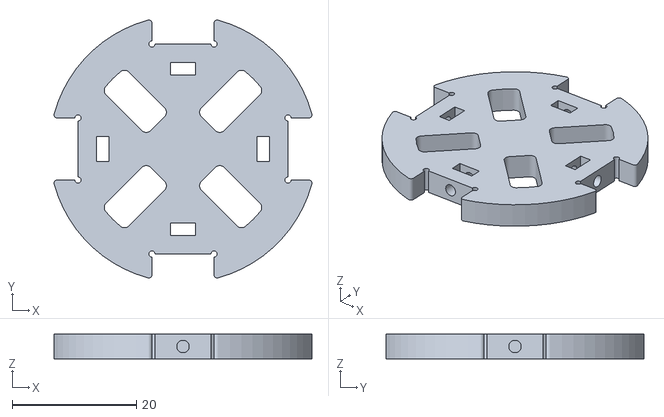
[picture p50: CAD file, 2026-02-14]
_CODE/_REF/hexapod-main/hexapod-main/mechanism/joint_cross.STL
41.5 x 41.5 x 4.00
