3dPaulHarvey/Hexapod/_CODE/_REF/hexapod-main/hexapod-main/mechanism/accessory_cable_holder.STL

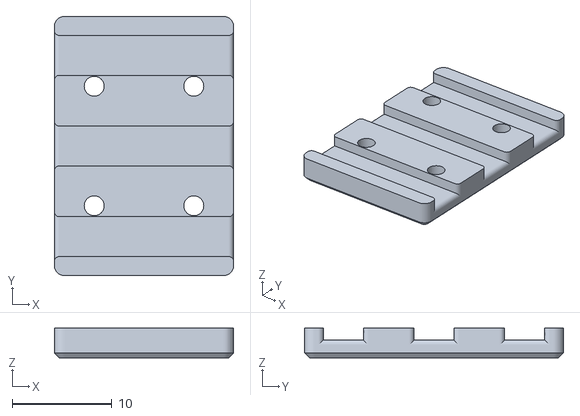
[picture p51: CAD file, 2026-02-14]
_CODE/_REF/hexapod-main/hexapod-main/mechanism/accessory_cable_holder.STL
18.0 x 26.0 x 3.00
