3dPaulHarvey/Hexapod/_CODE/_REF/hexapod-main/hexapod-main/mechanism/body_front_back.STL

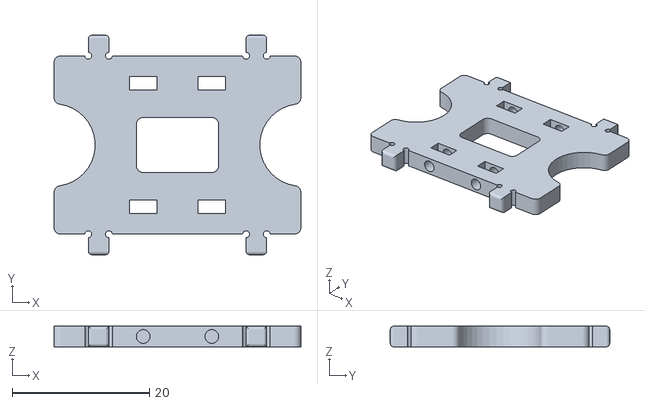
[picture p52: CAD file, 2026-02-14]
_CODE/_REF/hexapod-main/hexapod-main/mechanism/body_front_back.STL
36.0 x 32.0 x 3.00
