3dPaulHarvey/Hexapod/_CAD/HIP BASE- AZHEX.SLDPRT

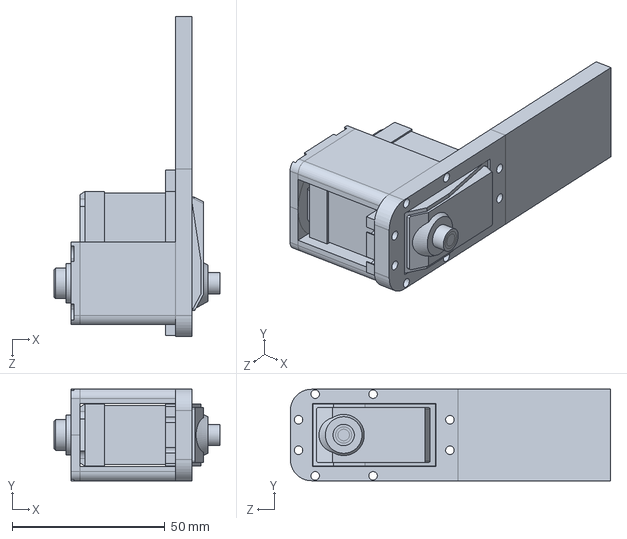
[picture p53: CAD file, 2026-02-27]
_CAD/HIP BASE- AZHEX.SLDPRT
54.4 x 30.0 x 105.0 mm
