3dPaulHarvey/Hexapod/_CODE/_REF/hexapod-main/hexapod-main/mechanism/body_base.STL

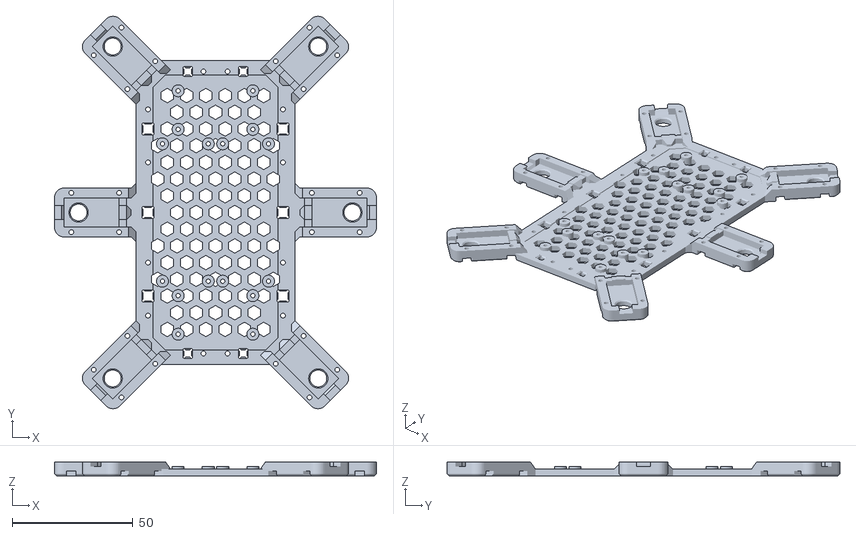
[picture p54: CAD file, 2026-02-14]
_CODE/_REF/hexapod-main/hexapod-main/mechanism/body_base.STL
133.6 x 162.9 x 6.00
