3dPaulHarvey/Hexapod/_CODE/_REF/hexapod-main/hexapod-main/mechanism/leg_bottom.STL

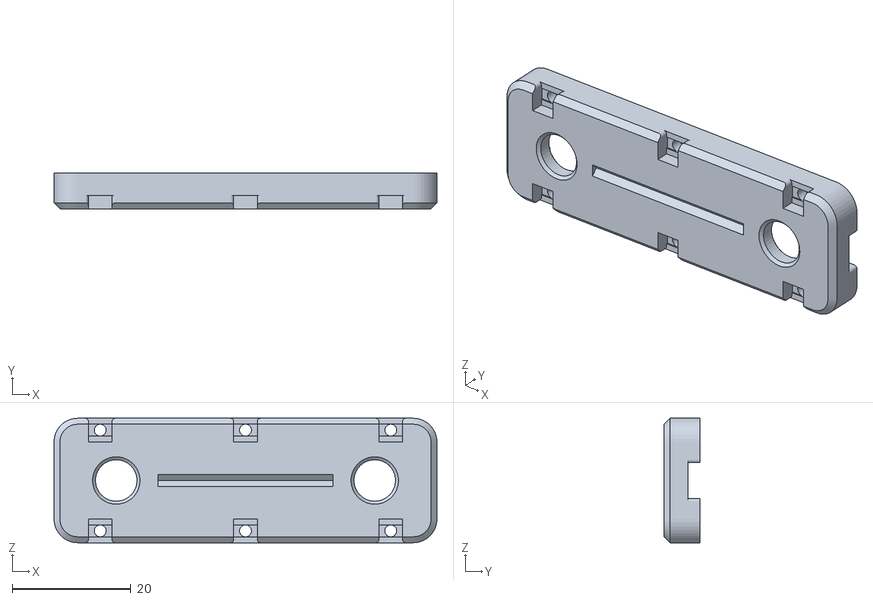
[picture p56: CAD file, 2026-02-14]
_CODE/_REF/hexapod-main/hexapod-main/mechanism/leg_bottom.STL
64.6 x 6.00 x 21.0
