3dPaulHarvey/Hexapod/_CODE/_REF/hexapod-main/hexapod-main/mechanism/foot_bottom.STL

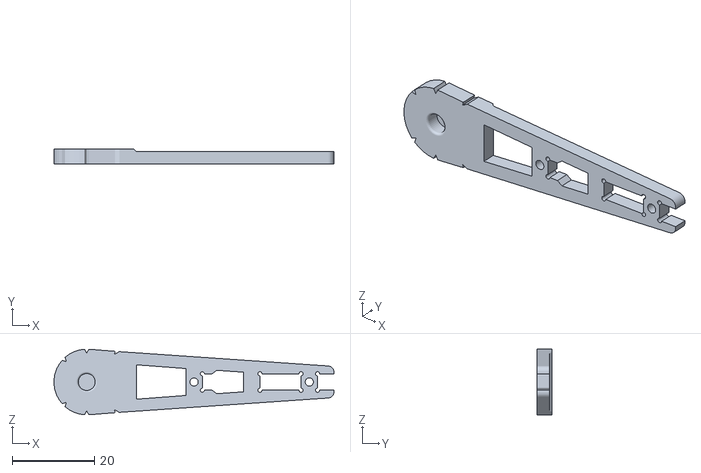
[picture p57: CAD file, 2026-02-14]
_CODE/_REF/hexapod-main/hexapod-main/mechanism/foot_bottom.STL
68.0 x 3.60 x 15.9
