3dPaulHarvey/Hexapod/_CODE/_REF/hexapod-main/hexapod-main/mechanism/foot_tip.STL

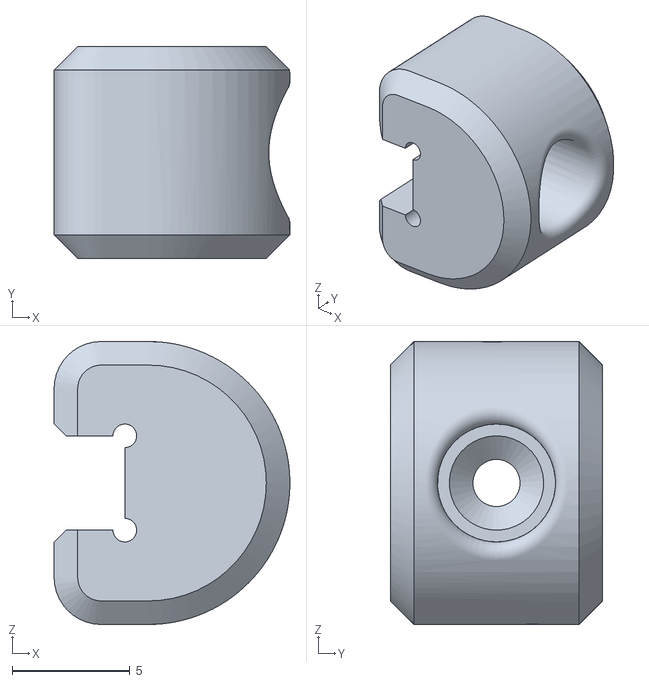
[picture p59: CAD file, 2026-02-14]
_CODE/_REF/hexapod-main/hexapod-main/mechanism/foot_tip.STL
10.0 x 9.00 x 12.0
