3dPaulHarvey/Hexapod/_CODE/_REF/hexapod-main/hexapod-main/mechanism/leg_side.STL

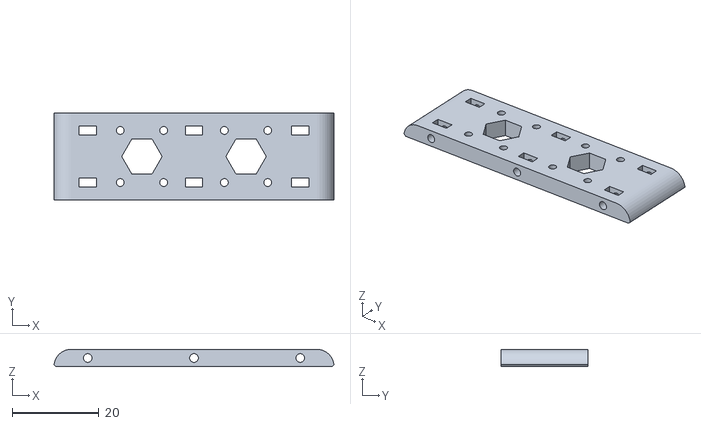
[picture p60: CAD file, 2026-02-14]
_CODE/_REF/hexapod-main/hexapod-main/mechanism/leg_side.STL
64.5 x 20.0 x 4.00
