3dPaulHarvey/Hexapod/_CAD/KNEE FRAME- AZHEX.SLDPRT

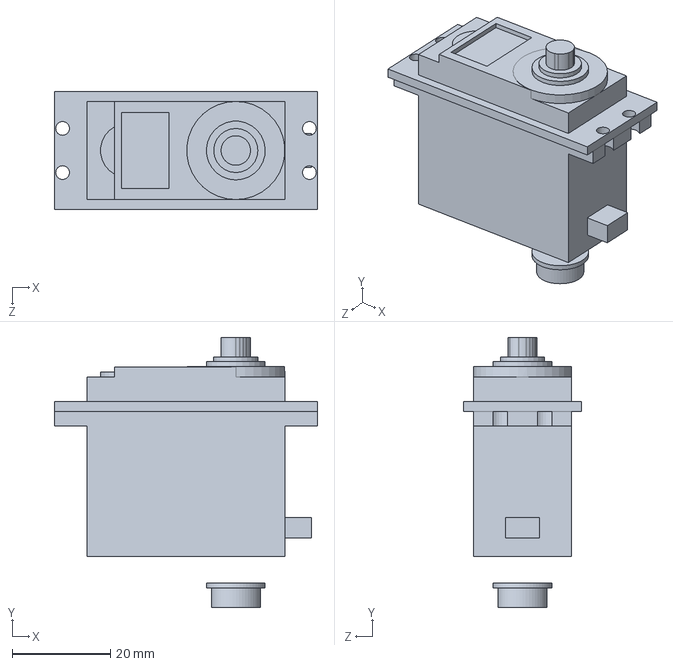
[picture p61: CAD file, 2026-02-14]
_CAD/KNEE FRAME- AZHEX.SLDPRT
53.6 x 55.0 x 24.0 mm
