3dPaulHarvey/Hexapod/_CODE/_REF/hexapod-main/hexapod-main/mechanism/leg_top.STL

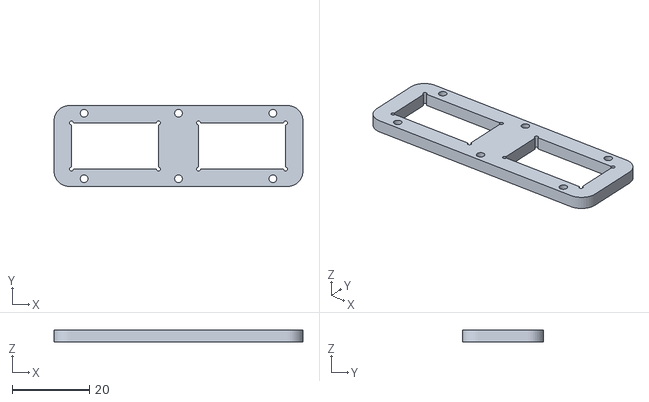
[picture p62: CAD file, 2026-02-14]
_CODE/_REF/hexapod-main/hexapod-main/mechanism/leg_top.STL
64.6 x 21.0 x 3.00
