3dPaulHarvey/Hexapod/_CAD/AZMO-SPIKE- AZHEX.SLDPRT

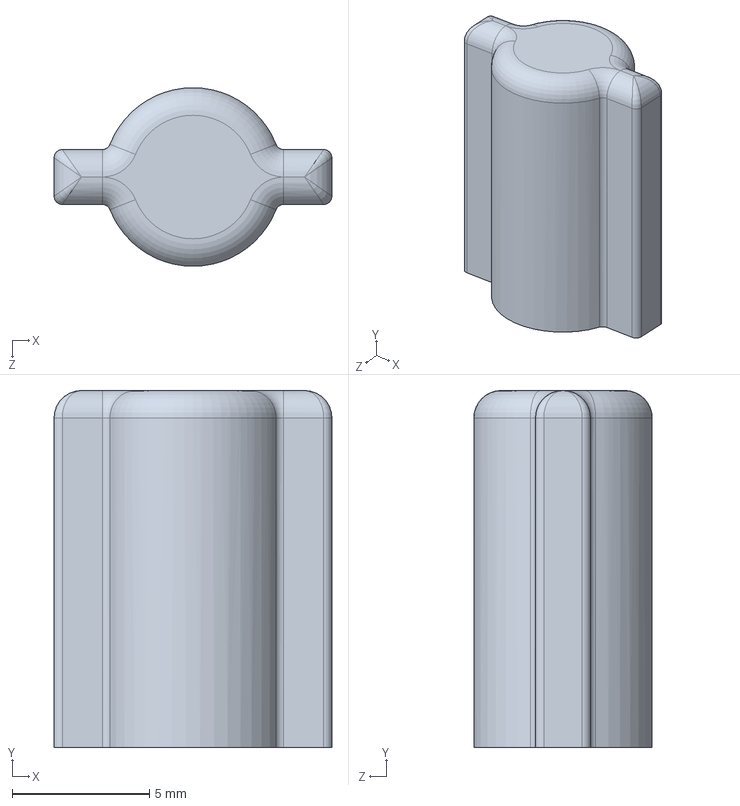
[picture p63: CAD file, 2026-02-14]
_CAD/AZMO-SPIKE- AZHEX.SLDPRT
10.1 x 13.0 x 6.50 mm
