3dPaulHarvey/Hexapod/_CAD/HIP FRAME- AZHEX.SLDPRT

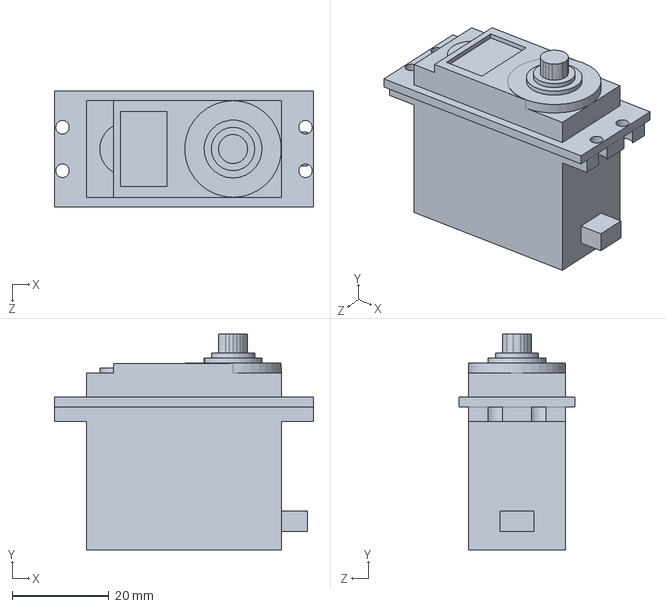
[picture p64: CAD file, 2026-02-14]
_CAD/HIP FRAME- AZHEX.SLDPRT
53.6 x 44.6 x 24.0 mm
