3dPaulHarvey/Hexapod/_CAD/ASSEM- AZMODAN HEXAPOD.SLDASM

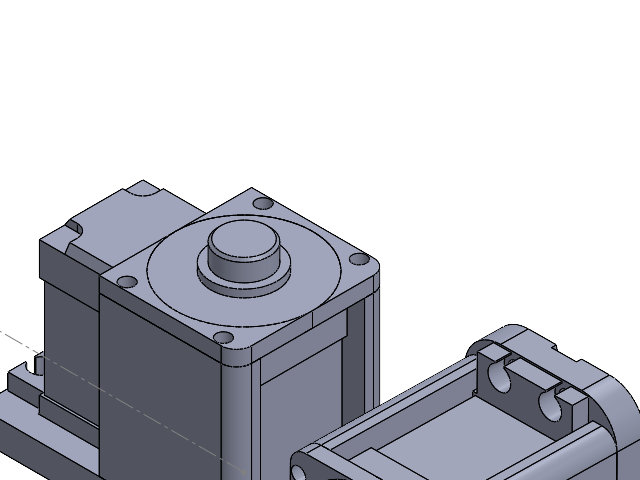
[picture p65: CAD file, 2026-02-14]
_CAD/ASSEM- AZMODAN HEXAPOD.SLDASM
BASE FRAME- AZHEX
KNEE LINK- AZHEX
HIP LINK- AZHEX
HIP KNEE CONNECTOR- AZHEX
