3dPaulHarvey/Hexapod/(list of files, cad)

Other CAD files:
_CODE/_REF/hexapod-main/hexapod-main/mechanism/body_servo_side1.STL
_CODE/_REF/hexapod-main/hexapod-main/mechanism/foot_top_mg90s.STL
_CODE/_REF/hexapod-main/hexapod-main/mechanism/joint_top_mg92b.STL
_CAD/ELBOW FRAME- AZHEX.SLDPRT
_CAD/BASE FRAME- AZHEX.SLDPRT
_CAD/10744694588274722515.STEP
_CAD/12628413548738139662.STEP
_CAD/12821959993174775273.STEP
_CAD/16895885497056685656.STEP
_CAD/21498040817728917729.STEP
_CAD/21743372949530586199.STEP
_CAD/22943455392512739675.STEP
_CAD/25683422861516175848.STEP
_CAD/25781735445633103277.STEP
_CAD/28776014485918558163.STEP
_CAD/33757216402115959080.STEP
_CAD/36805155832214813111.STEP
_CAD/42512567595882712324.STEP
_CAD/47924084808558159068.STEP
_CAD/49586654514015951373.STEP
_CAD/50923829254169754657.STEP
_CAD/55327678116831667428.STEP
_CAD/56263421387415789133.STEP
_CAD/56367321723064774354.STEP
_CAD/58181116816438622412.STEP
_CAD/58732790976482571437.STEP
_CAD/63869894315162475741.STEP
_CAD/65988119154836959389.STEP
_CAD/66728814294520135890.STEP
_CAD/69153556445714307521.STEP
_CAD/69264019343314719810.STEP
_CAD/69703497331229159012.STEP
_CAD/69785228142733508322.STEP
_CAD/71925177871217968866.STEP
_CAD/71958473607848677627.STEP
_CAD/72219292718229386215.STEP
_CAD/73917610743246201556.STEP
_CAD/74532151525074984829.STEP
_CAD/76698288815070591586.STEP
_CAD/79264529548196899412.STEP
_CAD/80515624811059997073.STEP
_CAD/80855637251054732728.STEP
_CAD/81696169891819994596.STEP
_CAD/84469361252289858349.STEP
_CAD/84913963419682438465.STEP
_CAD/85428458136718347074.STEP
_CAD/85501847853785252123.STEP
_CAD/87556132229655342820.STEP
_CAD/90302063317882697151.STEP
_CAD/90385559538015719719.STEP
_CAD/91214154756562905026.STEP
_CAD/93294970369998157888.STEP
_CAD/97183463123440664613.STEP
_CAD/98212783105054191515.STEP
_CAD/99666648975962613659.STEP
